Rampagy/bldc/README.md

# bldc

Open source brushless direct current (permanent magnet alternating current) hardware and software.
