Rampagy/bldc/hardware/README.md

# Kicad

Version 5.1.2

## Setup

Set Environment Variable `KILOCALLIB` to `path/to/bldc/hardware`.  This allows Kicad to find the custom schematic and footprint libraries:

* infineon.lib
* Interface_RS485.lib
* STM32F4-DISCOVERY-SIMON.lib
* custom.pretty
