Rampagy/bldc/hardware/Control/Documentation/3d_back.png

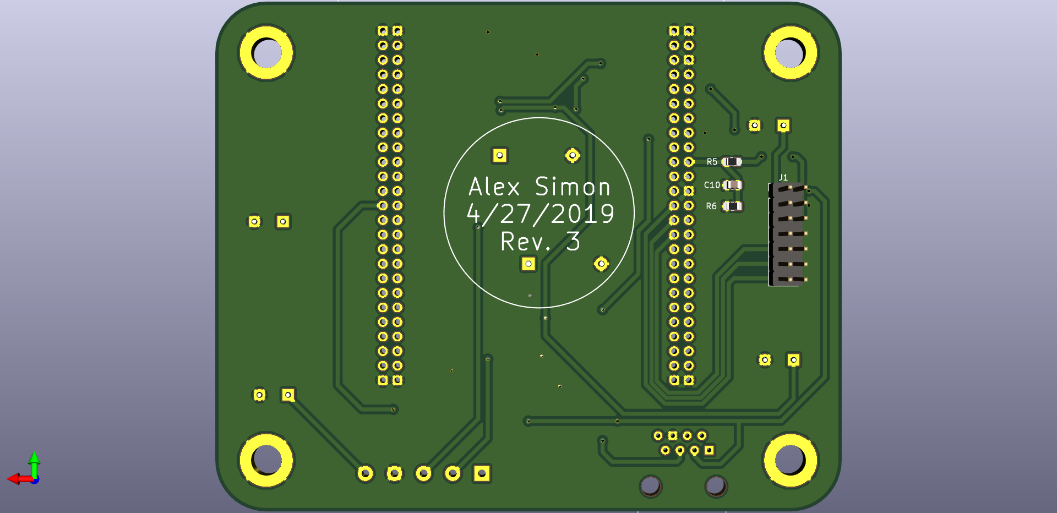
hardware/Control/Documentation/3d_back.png
