Rampagy/bldc/hardware/Control/Documentation/3d_front.png

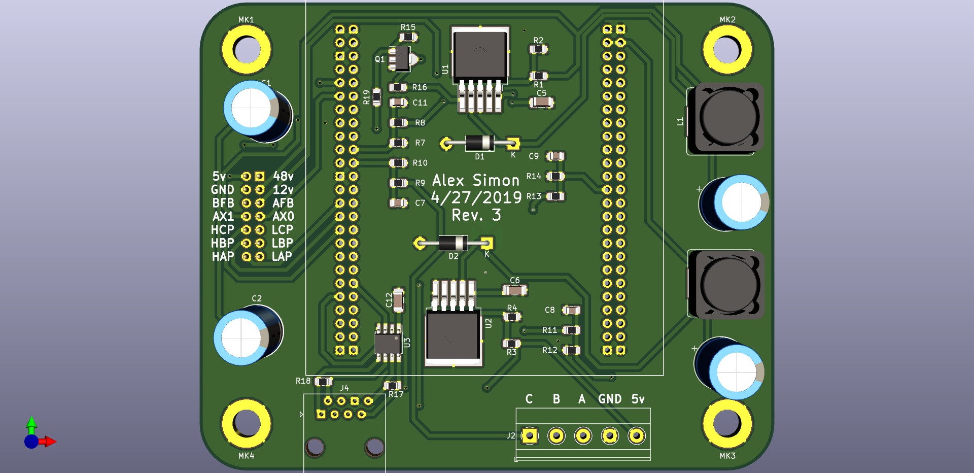
hardware/Control/Documentation/3d_front.png
