Rampagy/bldc/hardware/Operator/Documentation/3d_back.png

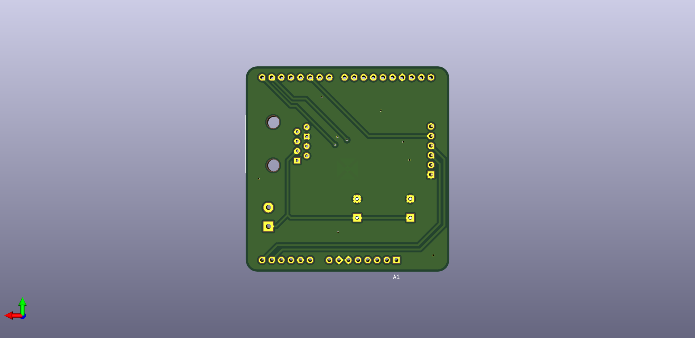
hardware/Operator/Documentation/3d_back.png
