Rampagy/bldc/hardware/Parts List 2.0.xlsx

 |  |  |  |  |  | control board | power board | both
 |  |  | total | 373.89
 |  | name | quantity | Price | digikey PN | link |  | ordered v1 | ordered v2 | ordered v3
 |  | Half Bridge Driver | 10 | 3.24 | 296-46403-1-ND | https://www.digikey.com/product-detail/en/texas-instruments/UCC27211DR/296-46403-1-ND/7033577 |  | n
 | dropin replacements | n-channel mosfet | 15 | 6.78 | IPB017N10N5ATMA1CT-ND | https://www.digikey.com/product-detail/en/infineon-technologies/IPB044N15N5ATMA1/IPB044N15N5ATMA1CT-ND/7667604 | https://www.digikey.com/product-detail/en/infineon-technologies/IPB017N10N5ATMA1/IPB017N10N5ATMA1CT-ND/5213948 | n
 |  | current sense | 4 | 4.80 | AD8210YRZ-ND | https://www.digikey.com/product-detail/en/analog-devices-inc/AD8210YRZ/AD8210YRZ-ND/1120048 |  | n
 |  | tvs diode, gate | 10 | 0.46 | SMBJ14A-FDICT-ND | https://www.digikey.com/product-detail/en/diodes-incorporated/SMBJ14A-13-F/SMBJ14A-FDICT-ND/816055 |  | n
 |  | Shottky diode | 10 | 0.45 | DFLS1100DICT-ND | https://www.digikey.com/product-detail/en/diodes-incorporated/DFLS1100-7/DFLS1100DICT-ND/765634 |  | n
buck converters | common | buck converters | 3 | 3.25 | 296-21841-1-ND | https://www.digikey.com/product-detail/en/texas-instruments/TL2575HV-ADJIKTTR/296-21841-1-ND/1629213 |  | y | y | y
 |  | schottky diode | 3 | 0.41 | 1N5819FSCT-ND | https://www.digikey.com/product-detail/en/on-semiconductor/1N5819/1N5819FSCT-ND/965482 |  | y | y | y
 |  | 2k ohm resistor | 10 | 0.10 | A126358CT-ND | https://www.digikey.com/product-detail/en/te-connectivity-passive-product/CRG0805F2K0/A126358CT-ND/7603413 |  | y | y | n
 |  | 100uF input filter cap | 10 | 0.63 | 493-12814-1-ND | https://www.digikey.com/product-detail/en/nichicon/UVR2A101MPD1TD/493-12814-1-ND/4328420 |  | y | y | n
 | 48v to 12v | 680uH inductor | 1 | 1.35 | SRR1210-681MCT-ND | https://www.digikey.com/product-detail/en/bourns-inc/SRR1210-681M/SRR1210-681MCT-ND/3461968 |  | y | y | y
 |  | 330uF cap | 2 | 0.42 | 493-7053-1-ND | https://www.digikey.com/product-detail/en/nichicon/UVZ1E331MPD1TD/493-7053-1-ND/3738374 |  | y | y | y
 |  | 18k ohm resistor | 10 | 0.36 | P18KDACT-ND | https://www.digikey.com/product-detail/en/panasonic-electronic-components/ERA-6AEB183V/P18KDACT-ND/1465977 |  | y | y | y
 | 48v to 5v | 330uH inductor | 1 | 1.35 | SRR1210-331MCT-ND | https://www.digikey.com/product-detail/en/bourns-inc/SRR1210-331M/SRR1210-331MCT-ND/3461965 |  | y | y | y
 |  | 6.04k ohm resistor | 2 | 0.10 | P6.04KCCT-ND | https://www.digikey.com/product-detail/en/panasonic-electronic-components/ERJ-6ENF6041V/P6.04KCCT-ND/119185 |  | y | y | y
 |  | 1.2mF cap, 16v | 5 | 0.69 | 493-15294-ND | https://www.digikey.com/product-detail/en/nichicon/UHV1C122MPD/493-15294-ND/2598237 |  | y | y | n
 |  | shunt resistor, 0.001, 2w | 6 | 0.68 | CSNL2512FT1L00CT-ND | https://www.digikey.com/product-detail/en/stackpole-electronics-inc/CSNL2512FT1L00/CSNL2512FT1L00CT-ND/1646259 |  | n
 |  | 10.0uF cap, 35v | 10 | 0.65 | 445-14418-1-ND | https://www.digikey.com/product-detail/en/tdk-corporation/C2012X5R1V106K125AC/445-14418-1-ND/3956084 |  | n
 |  | 0.68uF cap, 100v | 10 | 1.32 | 399-15953-1-ND | https://www.digikey.com/product-detail/en/kemet/C1210C684K1RACAUTO/399-15953-1-ND/7516453 |  | n
 |  | 10 ohm, 2w resistor | 10 | 0.39 | CRM2512-JW-100ELFCT-ND | https://www.digikey.com/product-detail/en/bourns-inc/CRM2512-JW-100ELF/CRM2512-JW-100ELFCT-ND/3438030 |  | n
 |  | 20kohm, 2/5w resistor | 10 | 0.72 | TNP20.0KACCT-ND | https://www.digikey.com/product-detail/en/vishay-dale/TNPW120620K0BEEA/TNP20.0KACCT-ND/1857150 |  | n
 |  | 1x1 screw terminal, 85 amps | 3 | 7.37 | 281-1598-ND | https://www.digikey.com/product-detail/en/weidmuller/1783660000/281-1598-ND/459455 |  | n
 |  | 1x1 screw terminal, 60 amps | 5 | 5.06 | 277-14522-ND | https://www.digikey.com/product-detail/en/phoenix-contact/1993763/277-14522-ND/4453000 |  | n
 |  | 2x25 female 0.1" header | 4 | 5.1 | SAM10038-ND | https://www.digikey.com/product-detail/en/samtec-inc/SSW-125-01-F-D/SAM10038-ND/6678775 |  | y | y | n
 |  | 1x5 screw terminal | 2 | 1.11 | ED2612-ND | https://www.digikey.com/product-detail/en/on-shore-technology-inc/OSTTC052162/ED2612-ND/614561 |  | y | y | y
 |  | 1x6 0.1" male header | 0 | 0.26 | 952-2372-ND | https://www.digikey.com/product-detail/en/harwin-inc/M20-9710646/952-2372-ND/3724334 |  | y
 |  | rj45 connector | 5 | 0.6 | 609-1046-ND | https://www.digikey.com/product-detail/en/amphenol-icc-fci/54602-908LF/609-1046-ND/1001360 |  | y | y | n
 |  | 2.2uF cap, 100v | 10 | 0.63 | 490-14438-1-ND | https://www.digikey.com/product-detail/en/murata-electronics/GCM31CC72A225KE02L/490-14438-1-ND/6606899 |  | y | y | n
 |  | 14pin shrouded connector | 2 | 0.33 | ED10522-ND | https://www.digikey.com/product-detail/en/on-shore-technology-inc/302-S141/ED10522-ND/2794233 |  | y | y | n
 |  | ribbon cable | 1 | 3.22 | M3DDA-1406R-ND | https://www.digikey.com/product-detail/en/3m/M3DDA-1406R/M3DDA-1406R-ND/230201 |  | y
 |  | 680 ohm resistor | 20 | 0.1 | A129747CT-ND | https://www.digikey.com/product-detail/en/te-connectivity-passive-product/CRGCQ0805F680R/A129747CT-ND/8577579 |  | y | y | n
 |  | 2.2nF cap, 25v | 10 | 0.36 | 478-3753-1-ND | https://www.digikey.com/product-detail/en/avx-corporation/08053A222JAT2A/478-3753-1-ND/1116451 |  | y | y | y
 |  | 30kohm, 1/8w resistor | 5 | 0.36 | P30KDACT-ND | https://www.digikey.com/product-detail/en/panasonic-electronic-components/ERA-6AEB303V/P30KDACT-ND/1465982 |  | y | y | y
 |  | rs232 to usb converter cable | 1 | 19.81 |  | https://www.amazon.com/Adafruit-Serial-TTL-232-Cable-ADA70/dp/B00SK8LK1W |  | y
 |  | NPN BJT, 80V, 1Amp | 2 | 0.47 | BCX5616CT-ND | https://www.digikey.com/product-detail/en/diodes-incorporated/BCX5616TA/BCX5616CT-ND/190920 |  | n | y | n
 |  | RS485 driver/receiver | 10 | 1.537 | 296-35376-1-ND | https://www.digikey.com/product-detail/en/texas-instruments/DS89C21TMX-NOPB/296-35376-1-ND/3739080 |  | n | y | n
 |  | 120 ohm resistor | 10 | 0.052 | A126336CT-ND | https://www.digikey.com/product-detail/en/te-connectivity-passive-product/CRG0805F120R/A126336CT-ND/7603391 |  | n | y | n
 |  | 1x2 Screw Terminal, 18 amps | 2 | 0.43 | 277-1667-ND | https://www.digikey.com/product-detail/en/phoenix-contact/1935161/277-1667-ND/568614 |  | n | y | n
 |  | 680uF cap, 100V | 5 | 2.05 | 493-1987-ND | https://www.digikey.com/product-detail/en/nichicon/UPW2A681MHD/493-1987-ND/589728
 |  | 4.7uF cap, 100V | 10 | 0.92 | 587-5038-1-ND | https://www.digikey.com/product-detail/en/taiyo-yuden/HMK325C7475KN-TE/587-5038-1-ND/6563881
