Rampagy/bldc/(threads)

Thread 2 (2019-06-14):

Go back to count up mode

Rampagy, 2019-06-14:
https://github.com/Rampagy/bldc/blob/b7856c2639916a426cf8b4d859cf875d4ca604d4/software/Control/pwm_output.c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

should be

    TIM_BaseStruct.TIM_CounterMode = TIM_CounterMode_Up;

Rampagy, 2019-06-14:
Going to stay with center aligned mode to reduce all of the phases switching at the same time and unnecessarily inducing EMI that isn't needed.

Closed 2019-06-14.

Thread 3 (2019-06-14):

Change to PWM mode 1

Rampagy, 2019-06-14:
https://github.com/Rampagy/bldc/blob/b7856c2639916a426cf8b4d859cf875d4ca604d4/software/Control/pwm_output.c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

should be

    TIM_OCStruct.TIM_OCMode = TIM_OCMode_PWM1;

Rampagy, 2019-06-14:
Going to stay with center aligned mode to reduce all of the phases switching at the same time and unnecessarily inducing EMI that isn't needed.

Closed 2019-06-14.

Thread 4 (2019-06-14):

Wrong Polarity

Rampagy, 2019-06-14:
https://github.com/Rampagy/bldc/blob/b7856c2639916a426cf8b4d859cf875d4ca604d4/software/Control/pwm_output.c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

should be

    TIM_OCStruct.TIM_OCPolarity = TIM_OCPolarity_High;
    TIM_OCStruct.TIM_OCNPolarity = TIM_OCNPolarity_High;

Closed 2019-06-17.

Thread 5 (2019-06-14):

Wrong period

Rampagy, 2019-06-14:
https://github.com/Rampagy/bldc/blob/b7856c2639916a426cf8b4d859cf875d4ca604d4/software/Control/pwm_output.c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

should be

    timerPeriod = (uint16_t)(((uint32_t)SystemCoreClock / PWM_FREQ_HZ) - 1);

This is to account for the fact that we are no longer doing center aligned mode.

Rampagy, 2019-06-14:
Going to stay with center aligned mode to reduce all of the phases switching at the same time and unnecessarily inducing EMI that isn't needed.

Closed 2019-06-14.

Thread 6 (2019-06-17):

Polarity Issue

Rampagy, 2019-06-17:
https://github.com/Rampagy/bldc/blob/72862fa5c6fe0d044080ef48e1f8bc80b7bbeef1/software/Control/pwm_output.c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

Let's give the below configuration a try and see if it gets us what we want.

    TIM_OCInitStructure.TIM_OCPolarity = TIM_OCPolarity_Low;
    TIM_OCInitStructure.TIM_OCNPolarity = TIM_OCNPolarity_Low;
    /* Set Idle state to Reset for all FETs, so break can be used for neutral */
    TIM_OCInitStructure.TIM_OCIdleState = TIM_OCIdleState_Set;
    TIM_OCInitStructure.TIM_OCNIdleState = TIM_OCIdleState_Reset;

Closed 2019-07-01.

Thread 7 (2019-07-08):

Incorrect Phase Angle Estimation

Rampagy, 2019-07-08:
https://github.com/Rampagy/bldc/blob/d132e3d7ee893cea09e6aa9a4d93e508efb8d261/software/Control/motor_control.c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

The above code incorrectly drives the quadrature angle 60 degrees ahead of the direct angle when PHASE_PREDICTION is enabled.  To fix this issue the below changes are recommended:

    #ifdef PHASE_PREDICTION
        uint16_t currentTimerCount = motorSpeedTimerOverrun ? TIM13_PERIOD : TIM13->CNT;
        uint16_t predictedPhaseAngle = (((uint32_t)currentTimerCount * 100 * 60) / motorSpeedCount) / 100;
    #else
        // half of the hall effect resolution, so that active torque region is centered around max torque point
        uint16_t predictedPhaseAngle = 30;
    #endif

        int16_t quadratureAxisAngle = checkAngleOverflow(directAxisAngle + 90 + predictedPhaseAngle);

Rampagy, 2019-07-09:
Fixed PHASE_PREDICTION bug with commit: 08e51591bc963561a74c99b4e07ac175a42cce6e

Closed 2019-07-09.
