Rampagy/bldc/hardware/Control/Documentation/control_v1.pdf

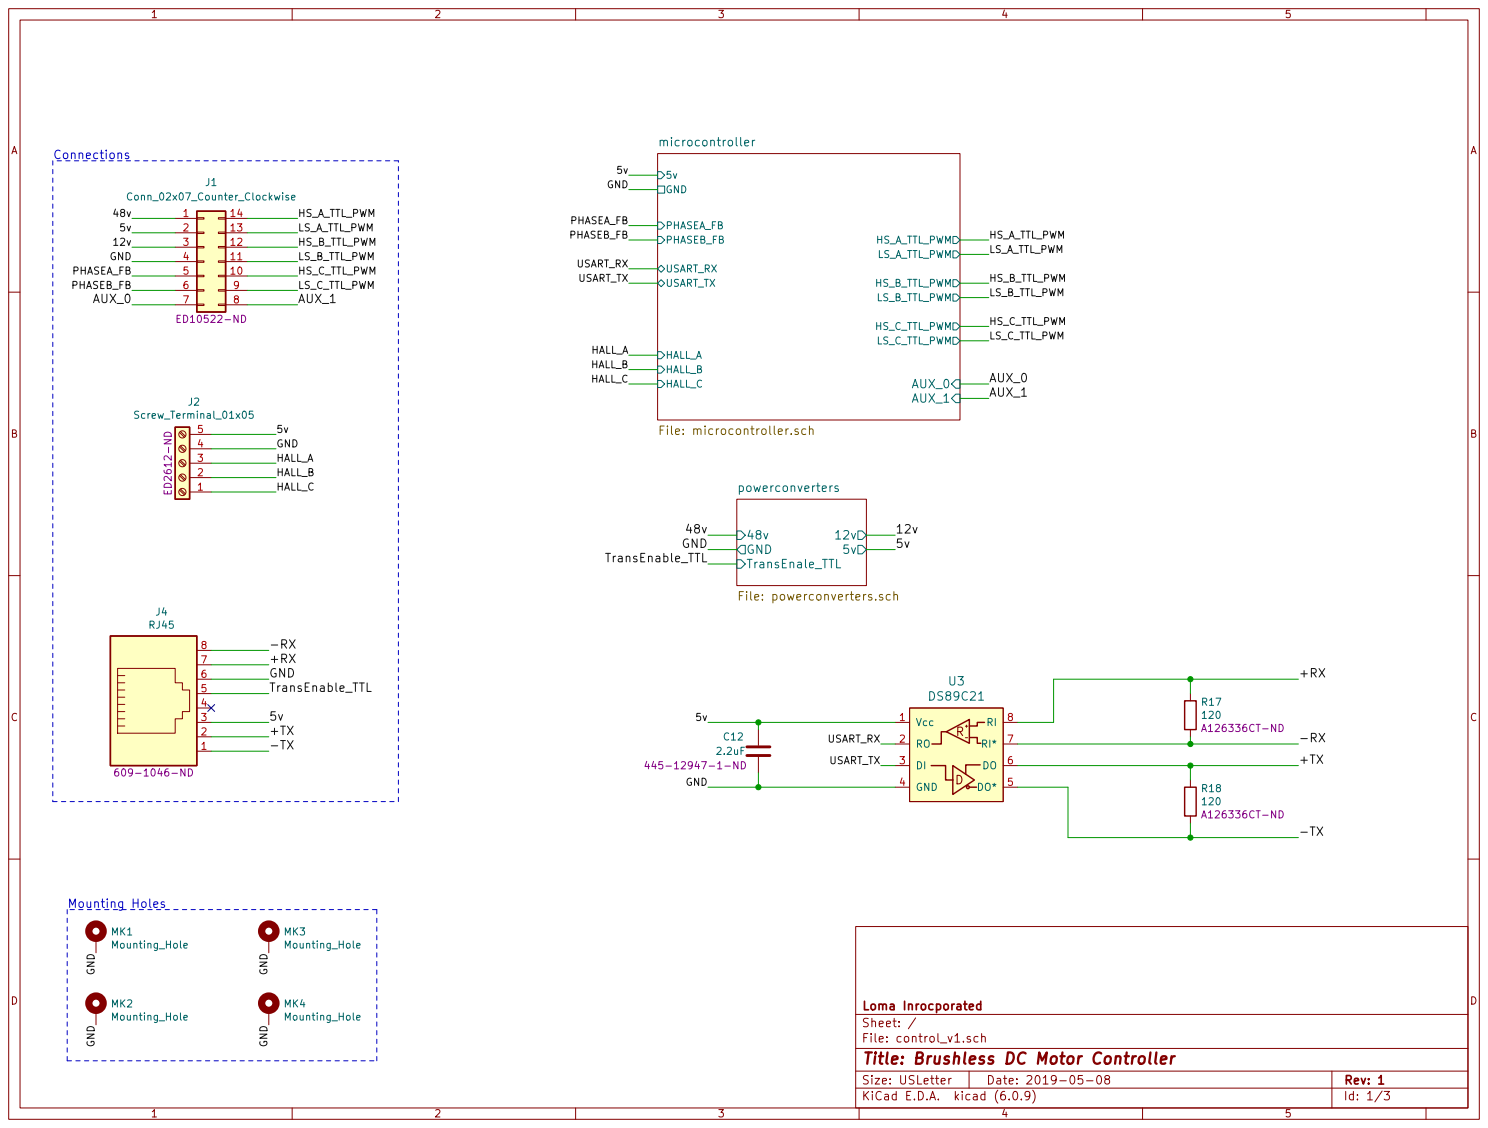
[picture p9: page 1]

File: control_v1.sch Sheet: / Loma Inrocporated

Id: 1/3 Title: Brushless DC Motor Controller

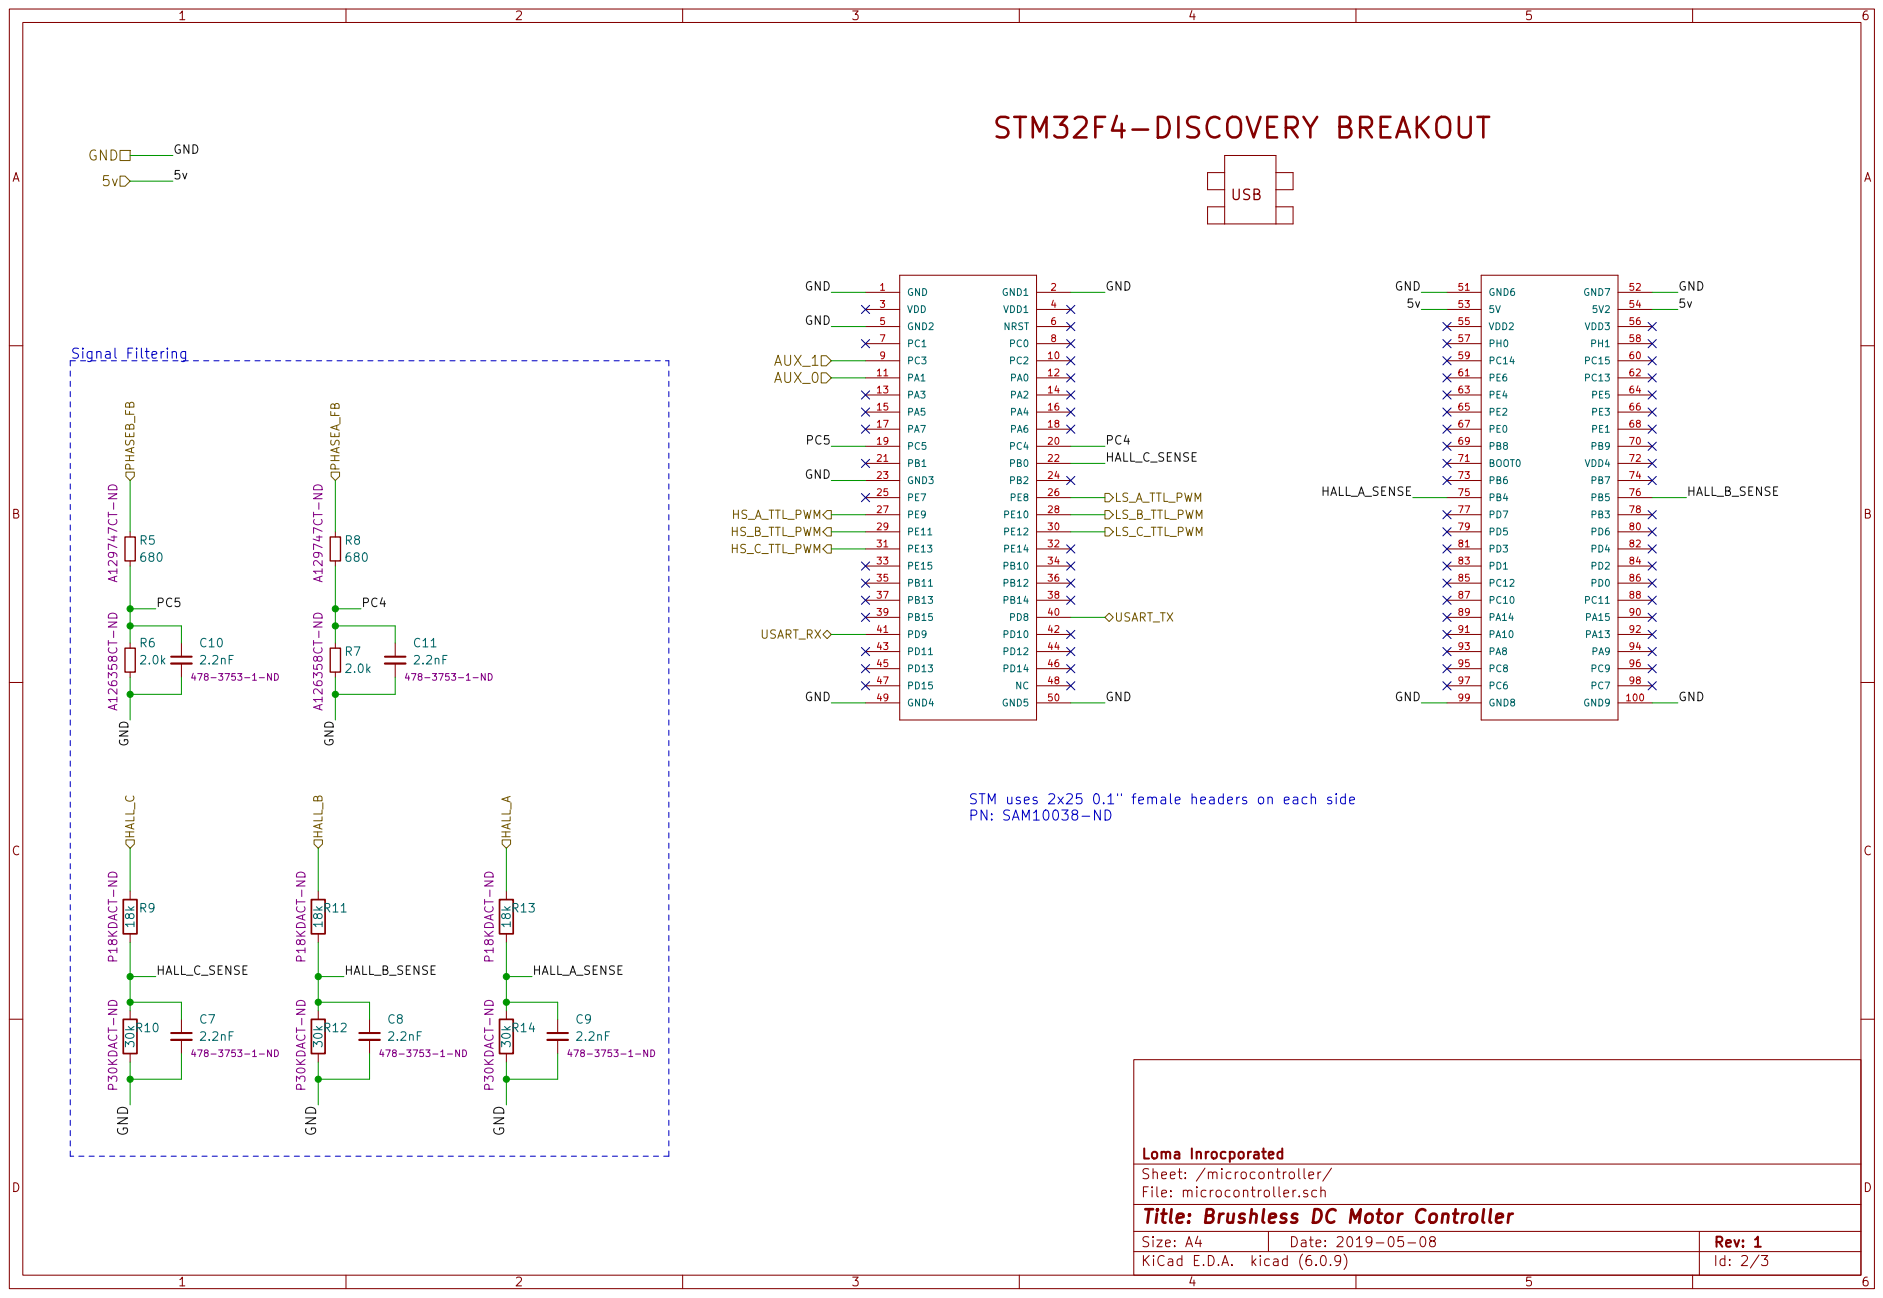
[picture p10: page 2]

Id: 2/3 Title: Brushless DC Motor Controller File: microcontroller.sch Sheet: /microcontroller/ Loma Inrocporated C10

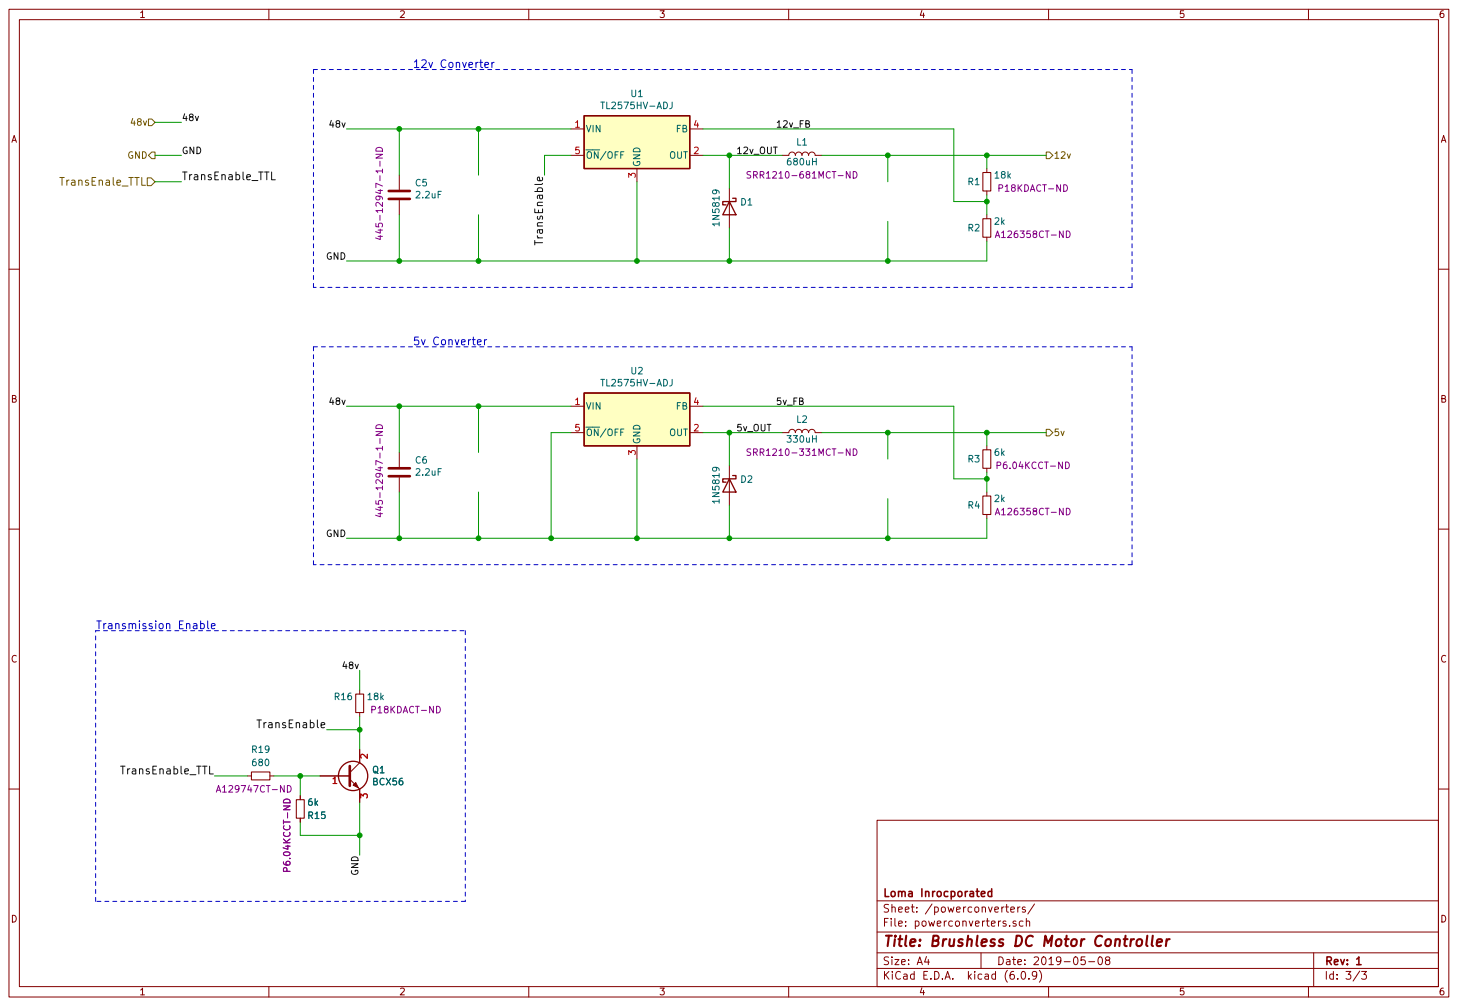
[picture p11: page 3]

3 FB 4 ~{ON}/OFF 5 U1 TL2575HV-ADJ R2 2kA126358CT-ND

3 FB 4 ~{ON}/OFF 5 U2 TL2575HV-ADJ R15
48v GND

Loma Inrocporated
Sheet: /powerconverters/
File: powerconverters.sch
Id: 3/3 Title: Brushless DC Motor Controller
