Rampagy/bldc/hardware/Power/Documentation/bldc_v1.pdf

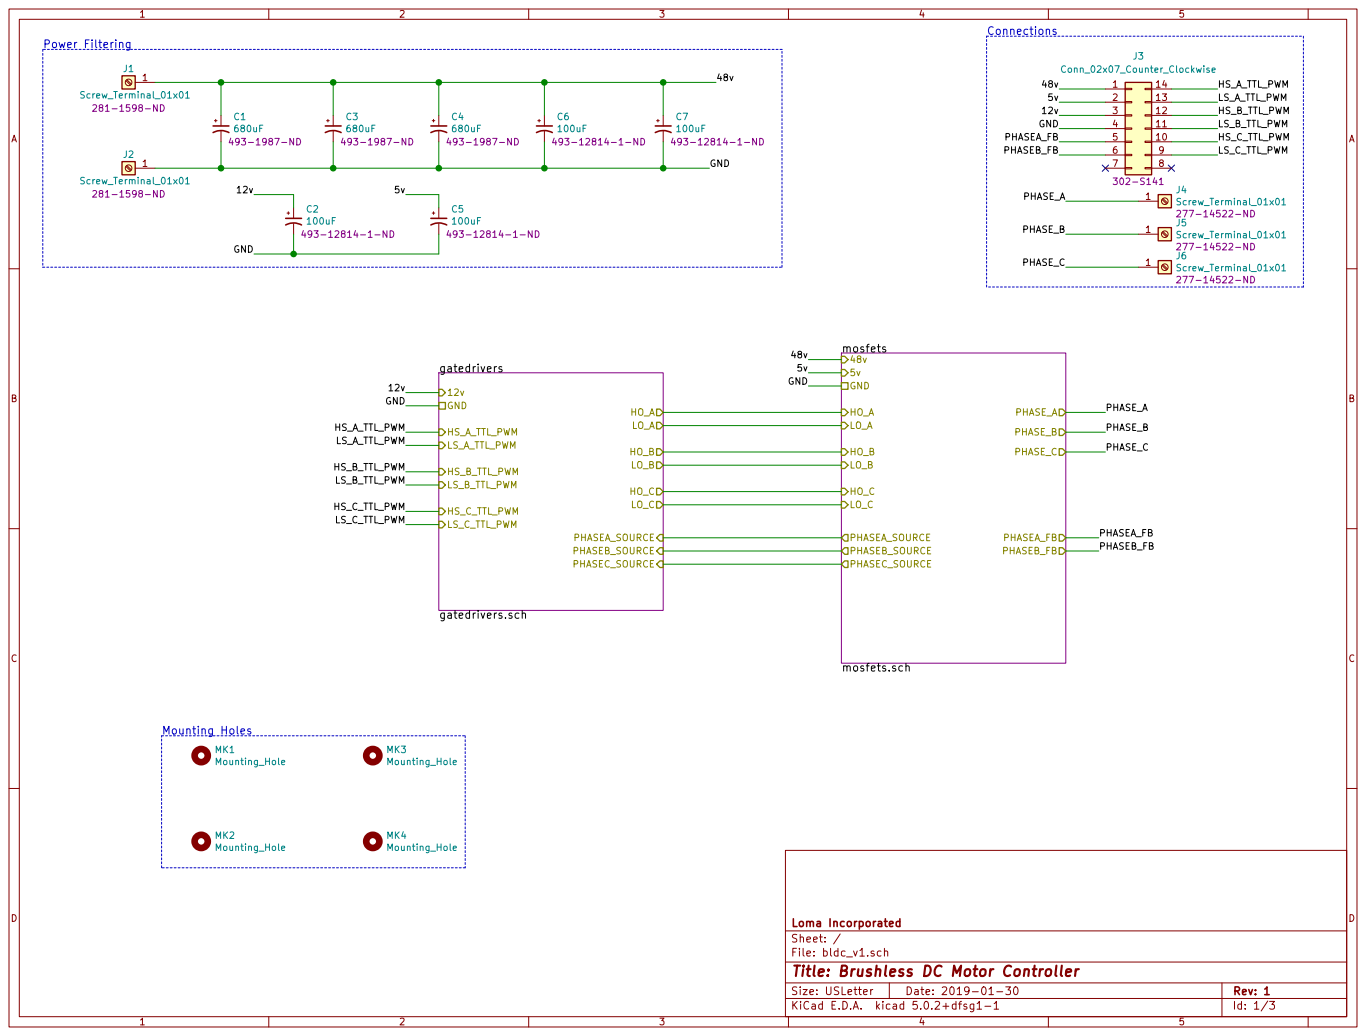
[picture p12: page 1]

File: bldc_v1.sch Sheet: / Loma Incorporated

Id: 1/3 Title: Brushless DC Motor Controller

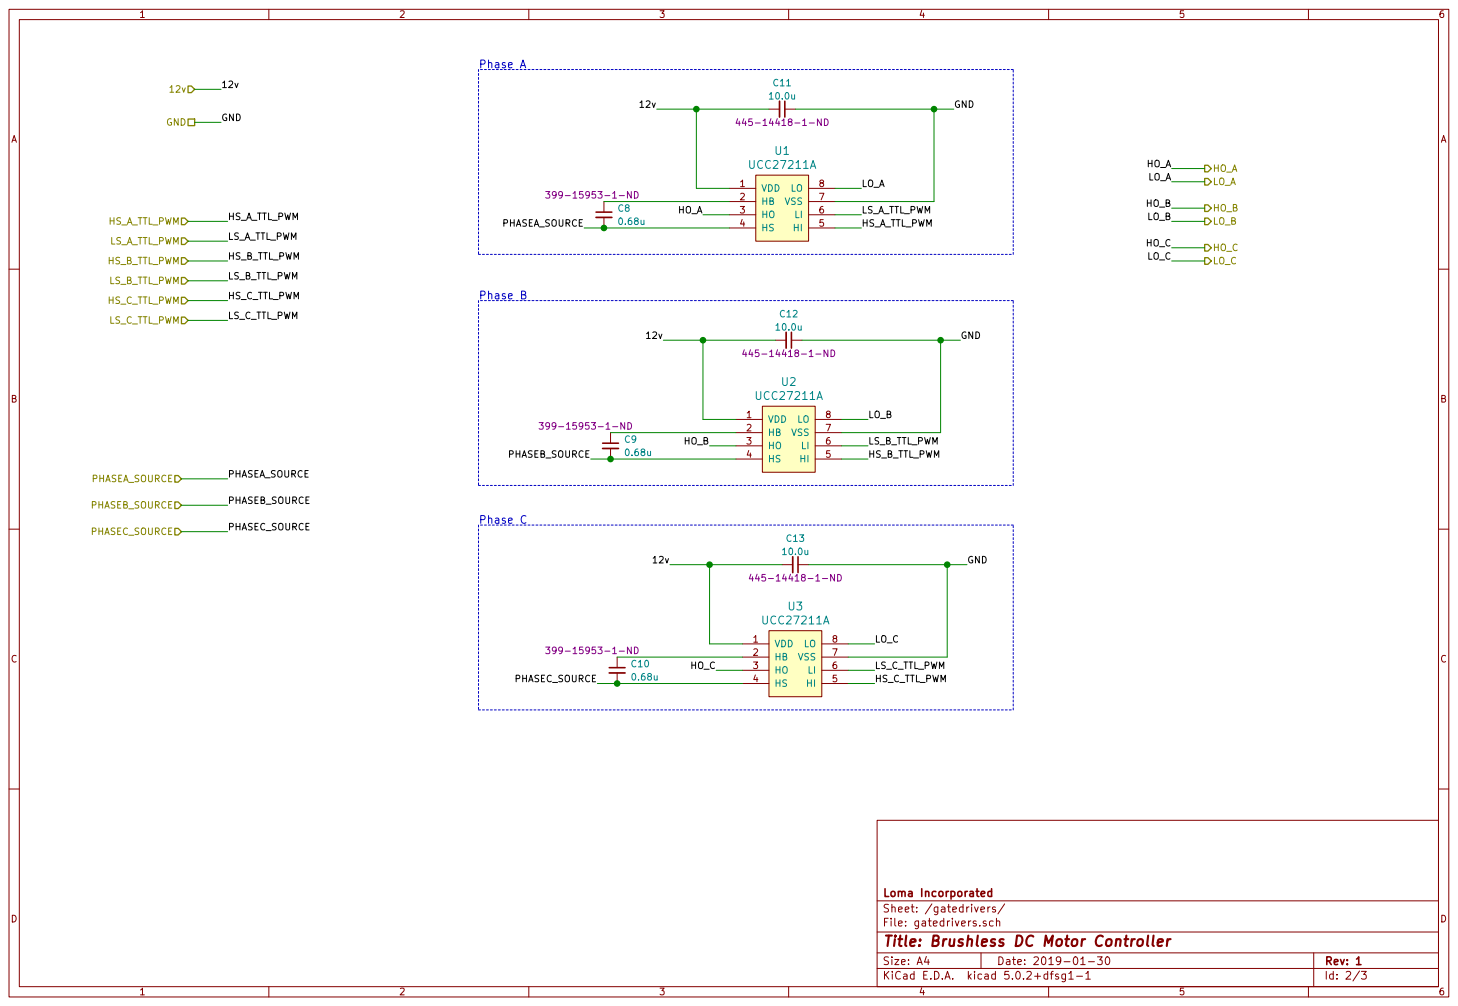
[picture p13: page 2]

Loma Incorporated
Sheet: /gatedrivers/
File: gatedrivers.sch
Id: 2/3 Title: Brushless DC Motor Controller

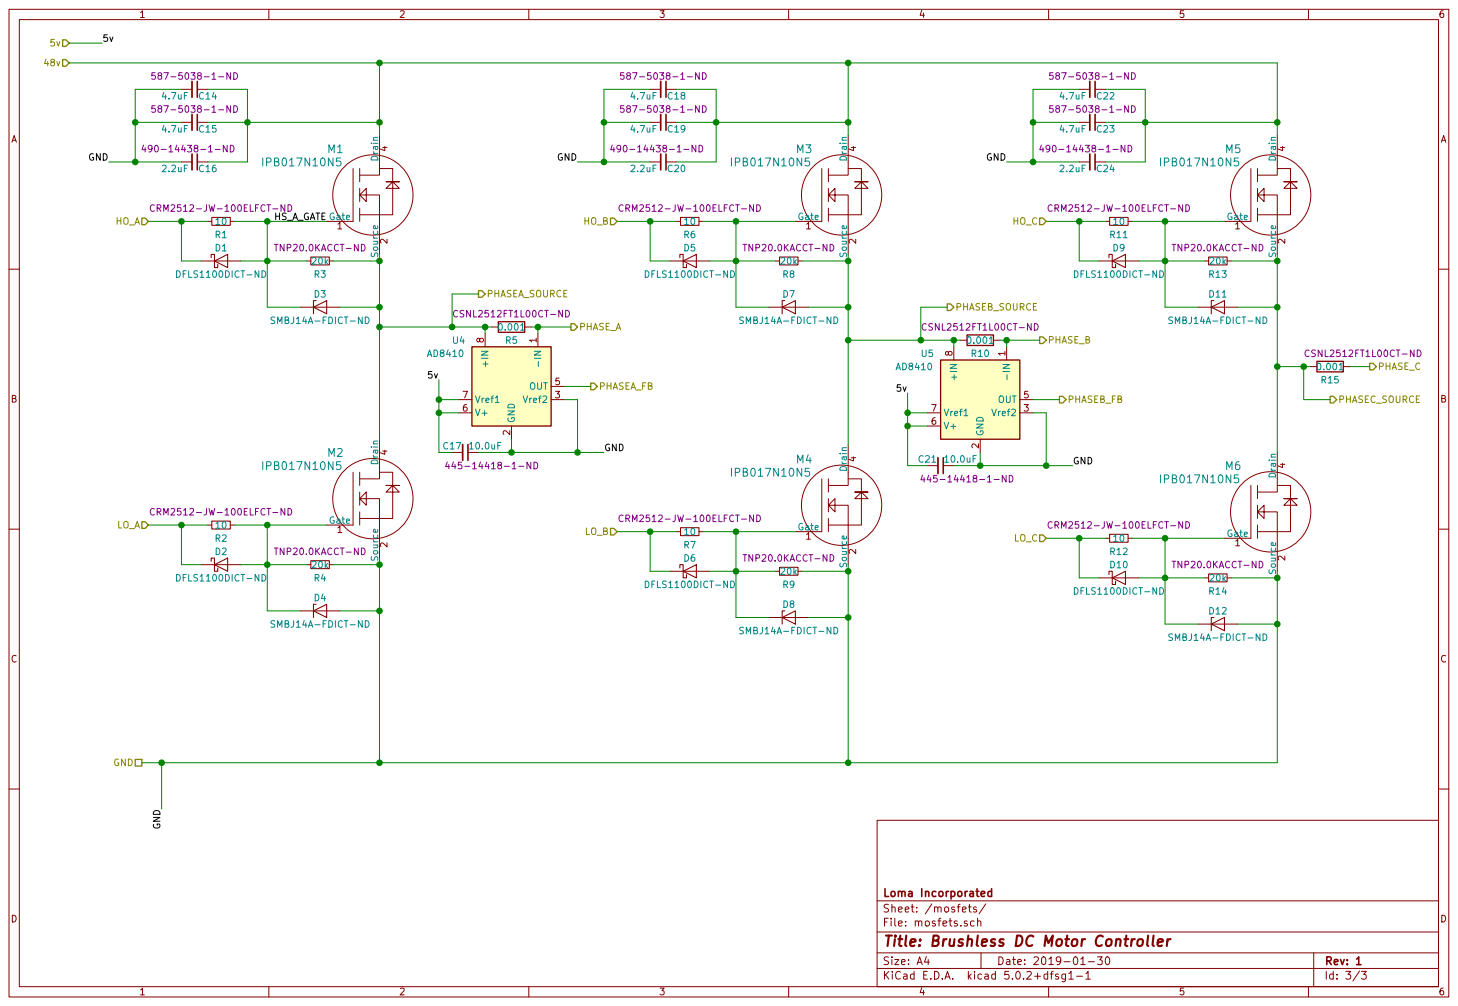
[picture p14: page 3]

D11 SMBJ14A-FDICT-ND GND Gate

Id: 3/3 Title: Brushless DC Motor Controller File: mosfets.sch Sheet: /mosfets/ Loma Incorporated
