Rampagy/bldc/hardware/Operator/Documentation/board_expanded.pdf

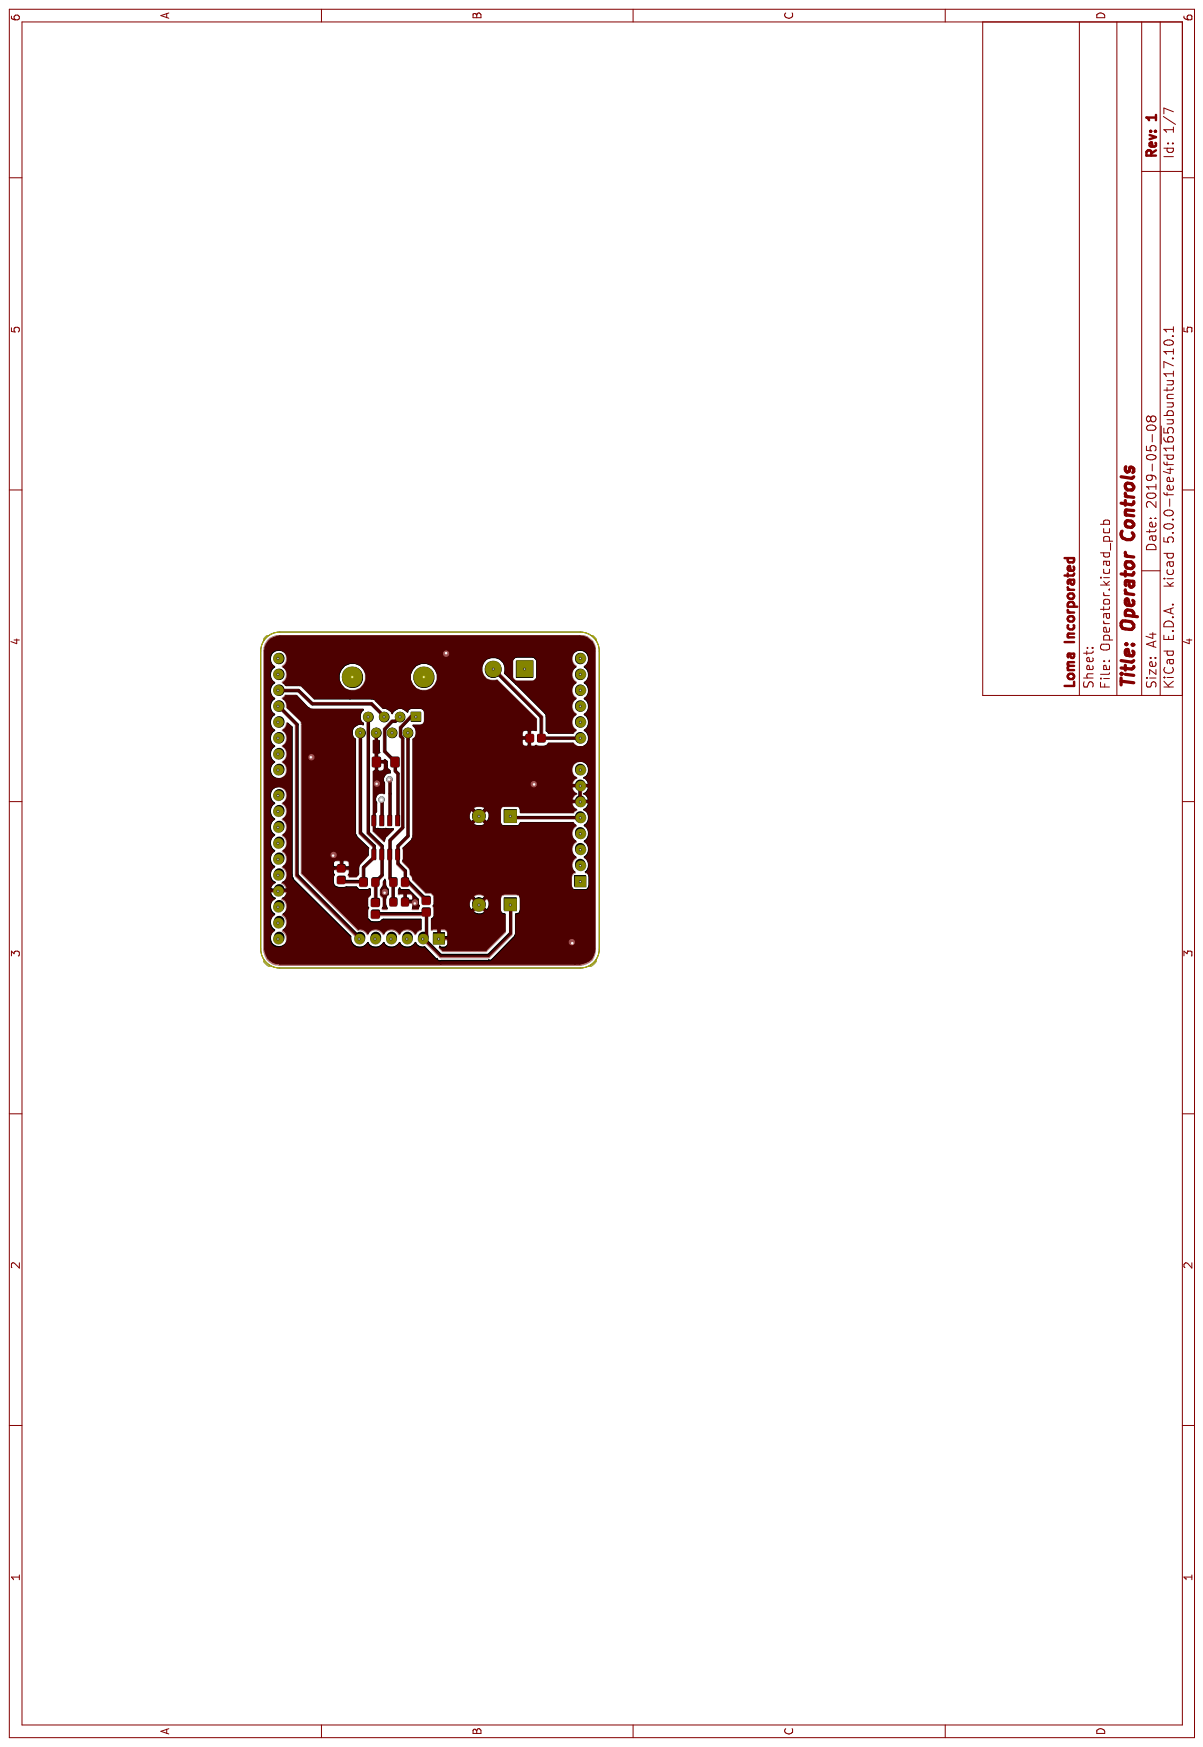
[picture p15: page 1]

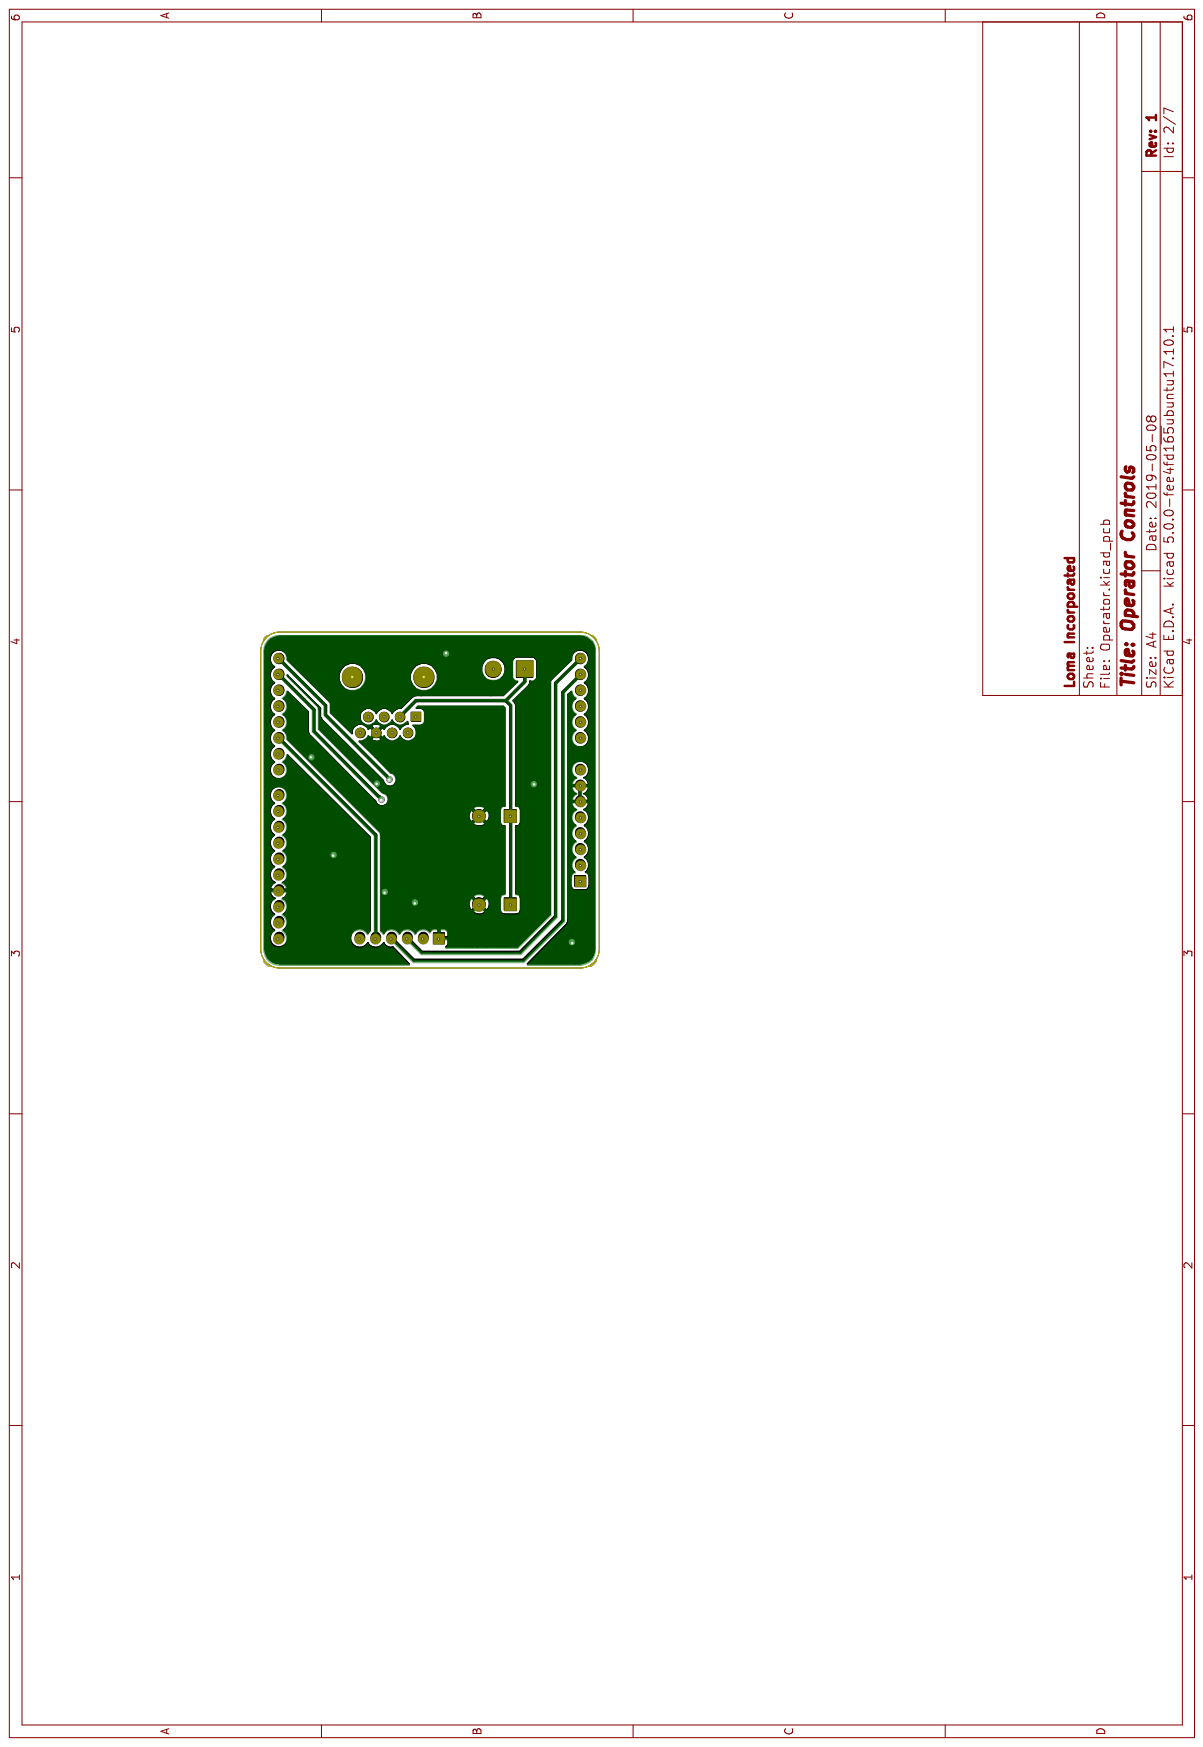
[picture p16: page 2]

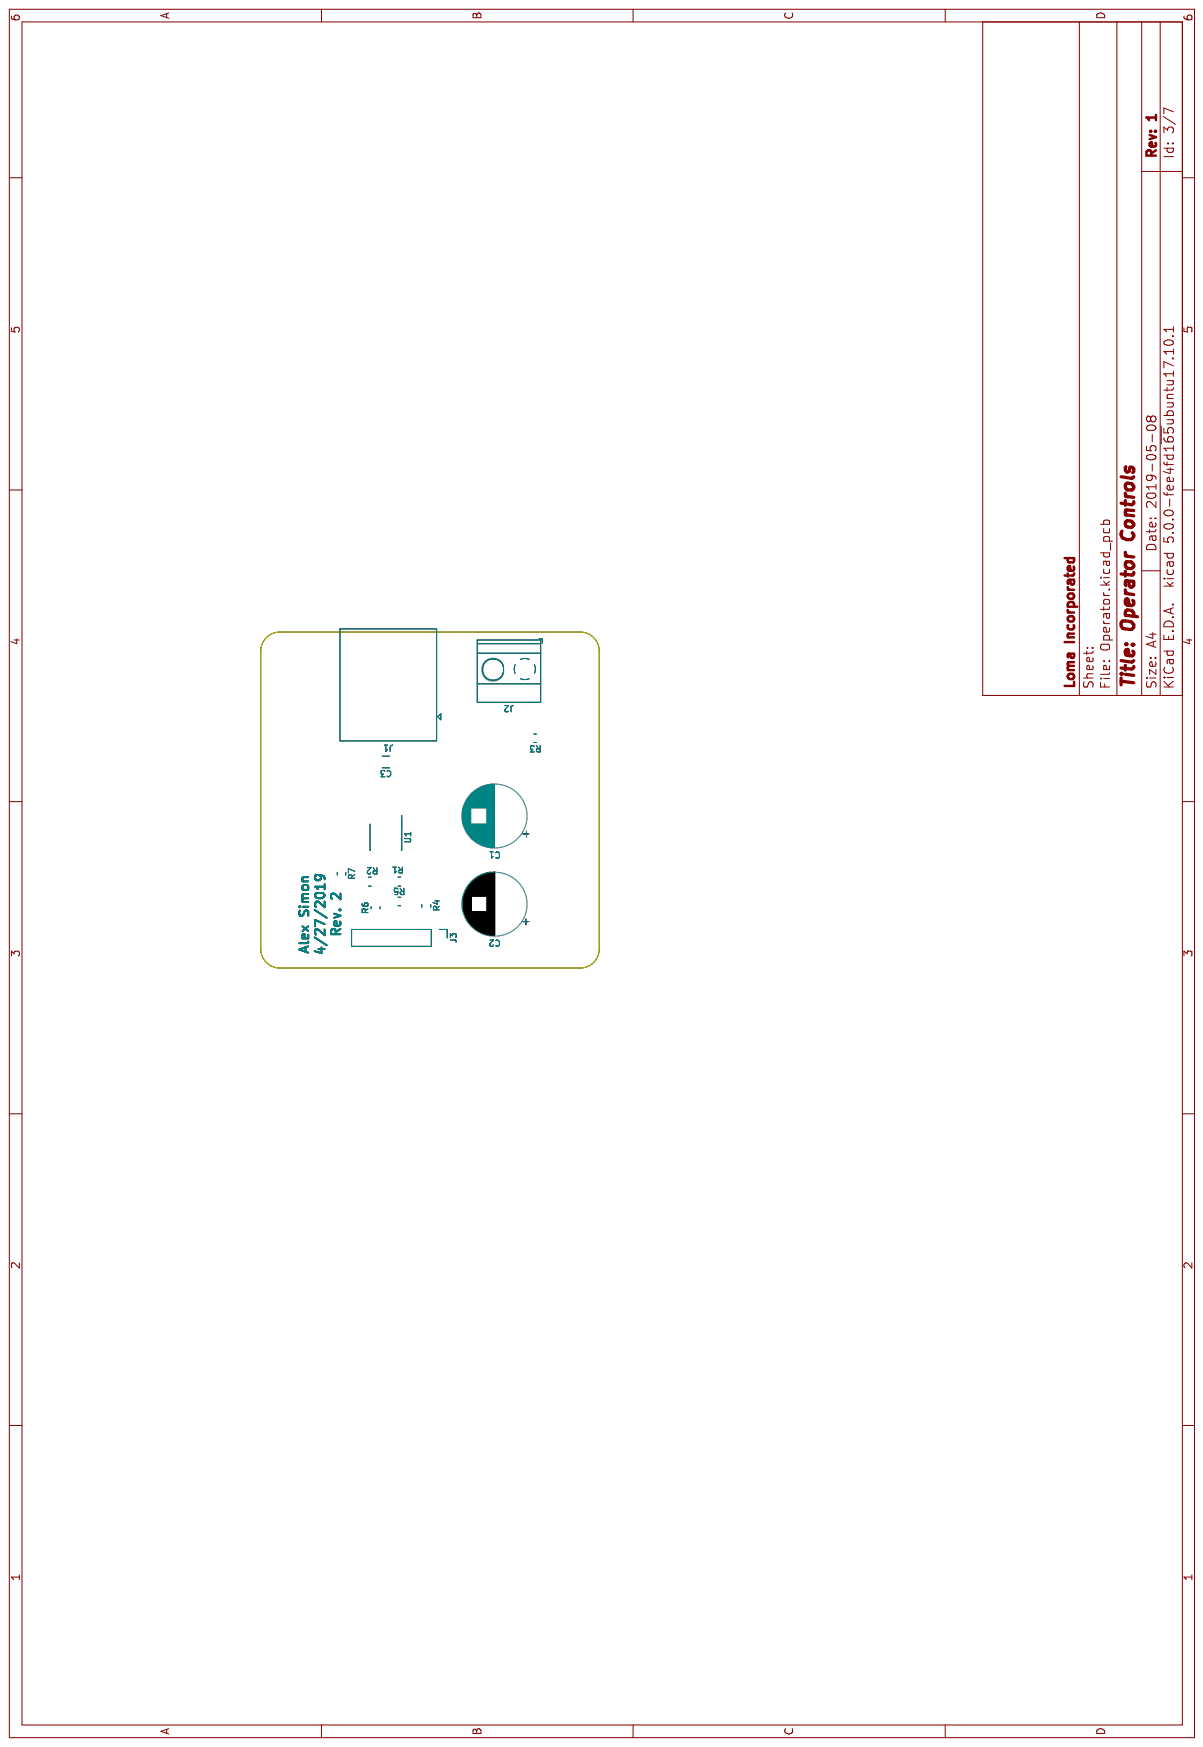
[picture p17: page 3]

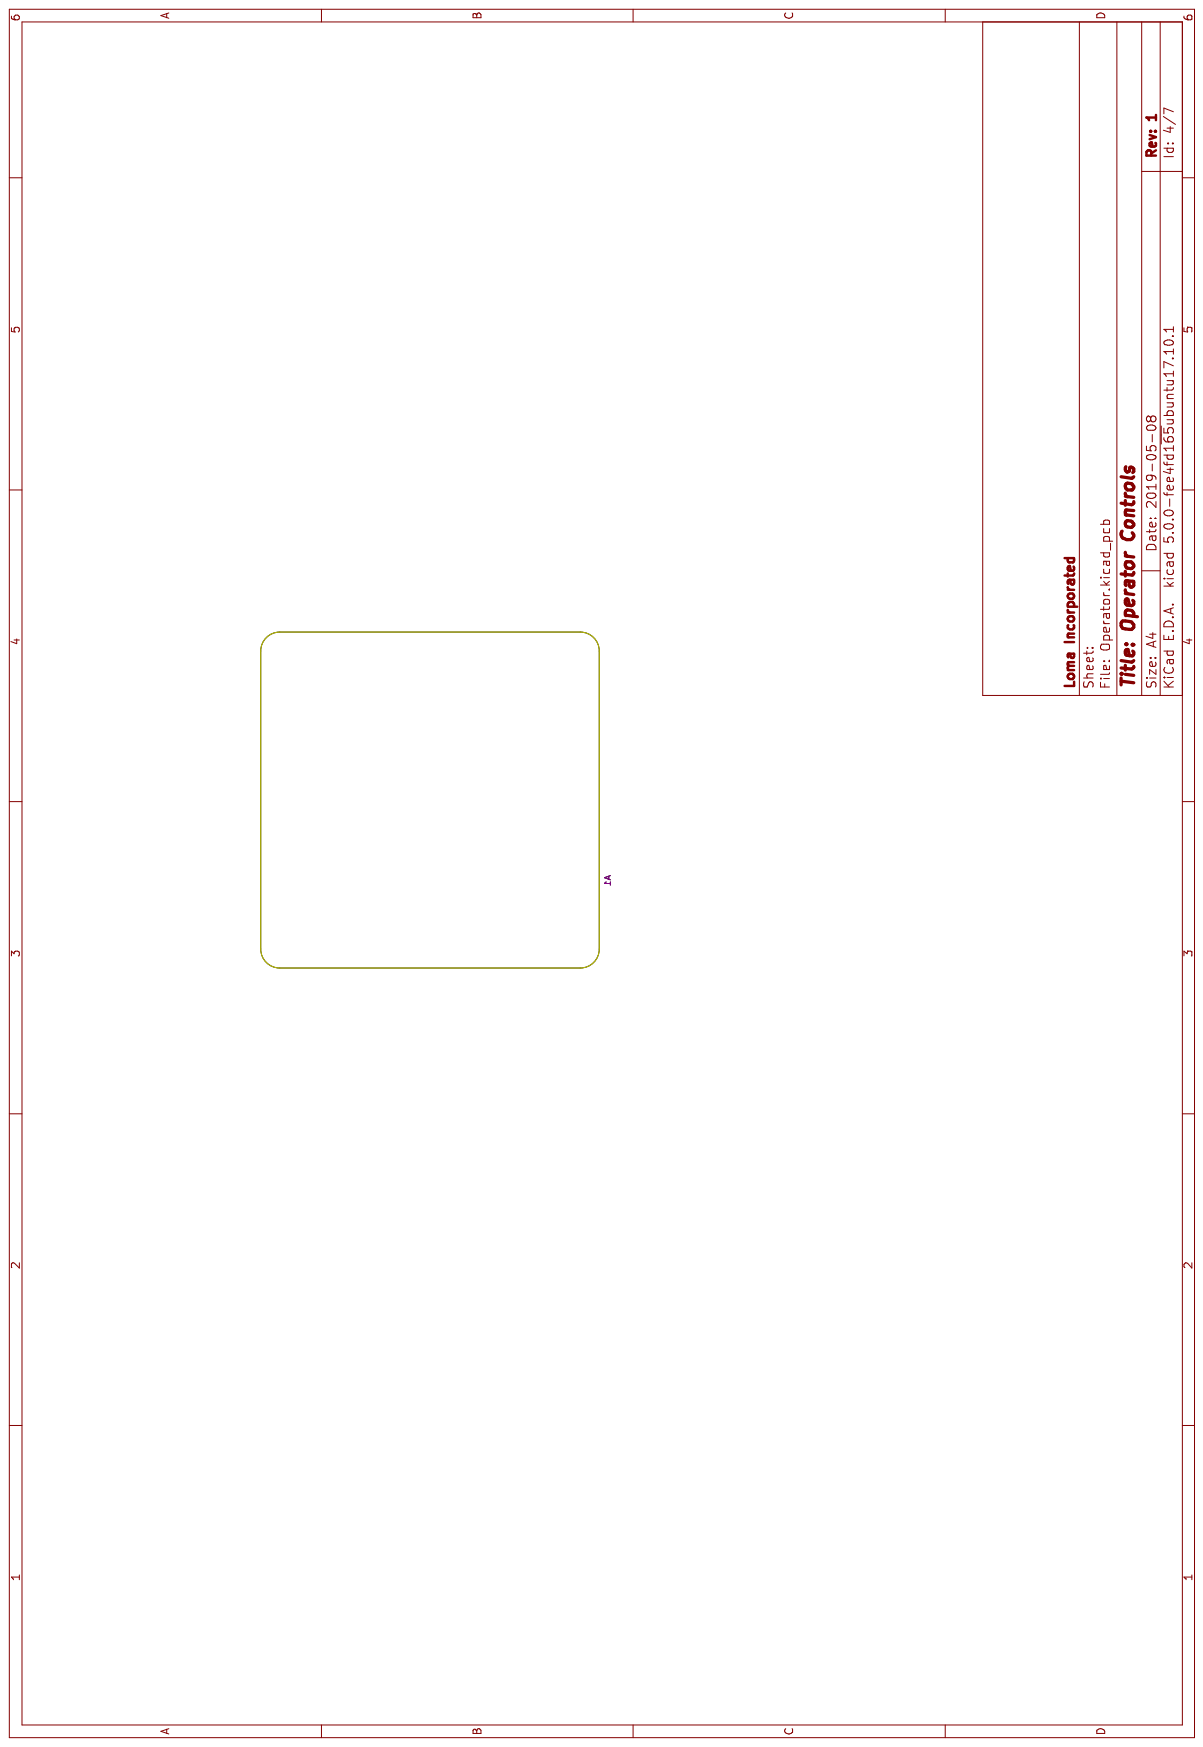
[picture p18: page 4]

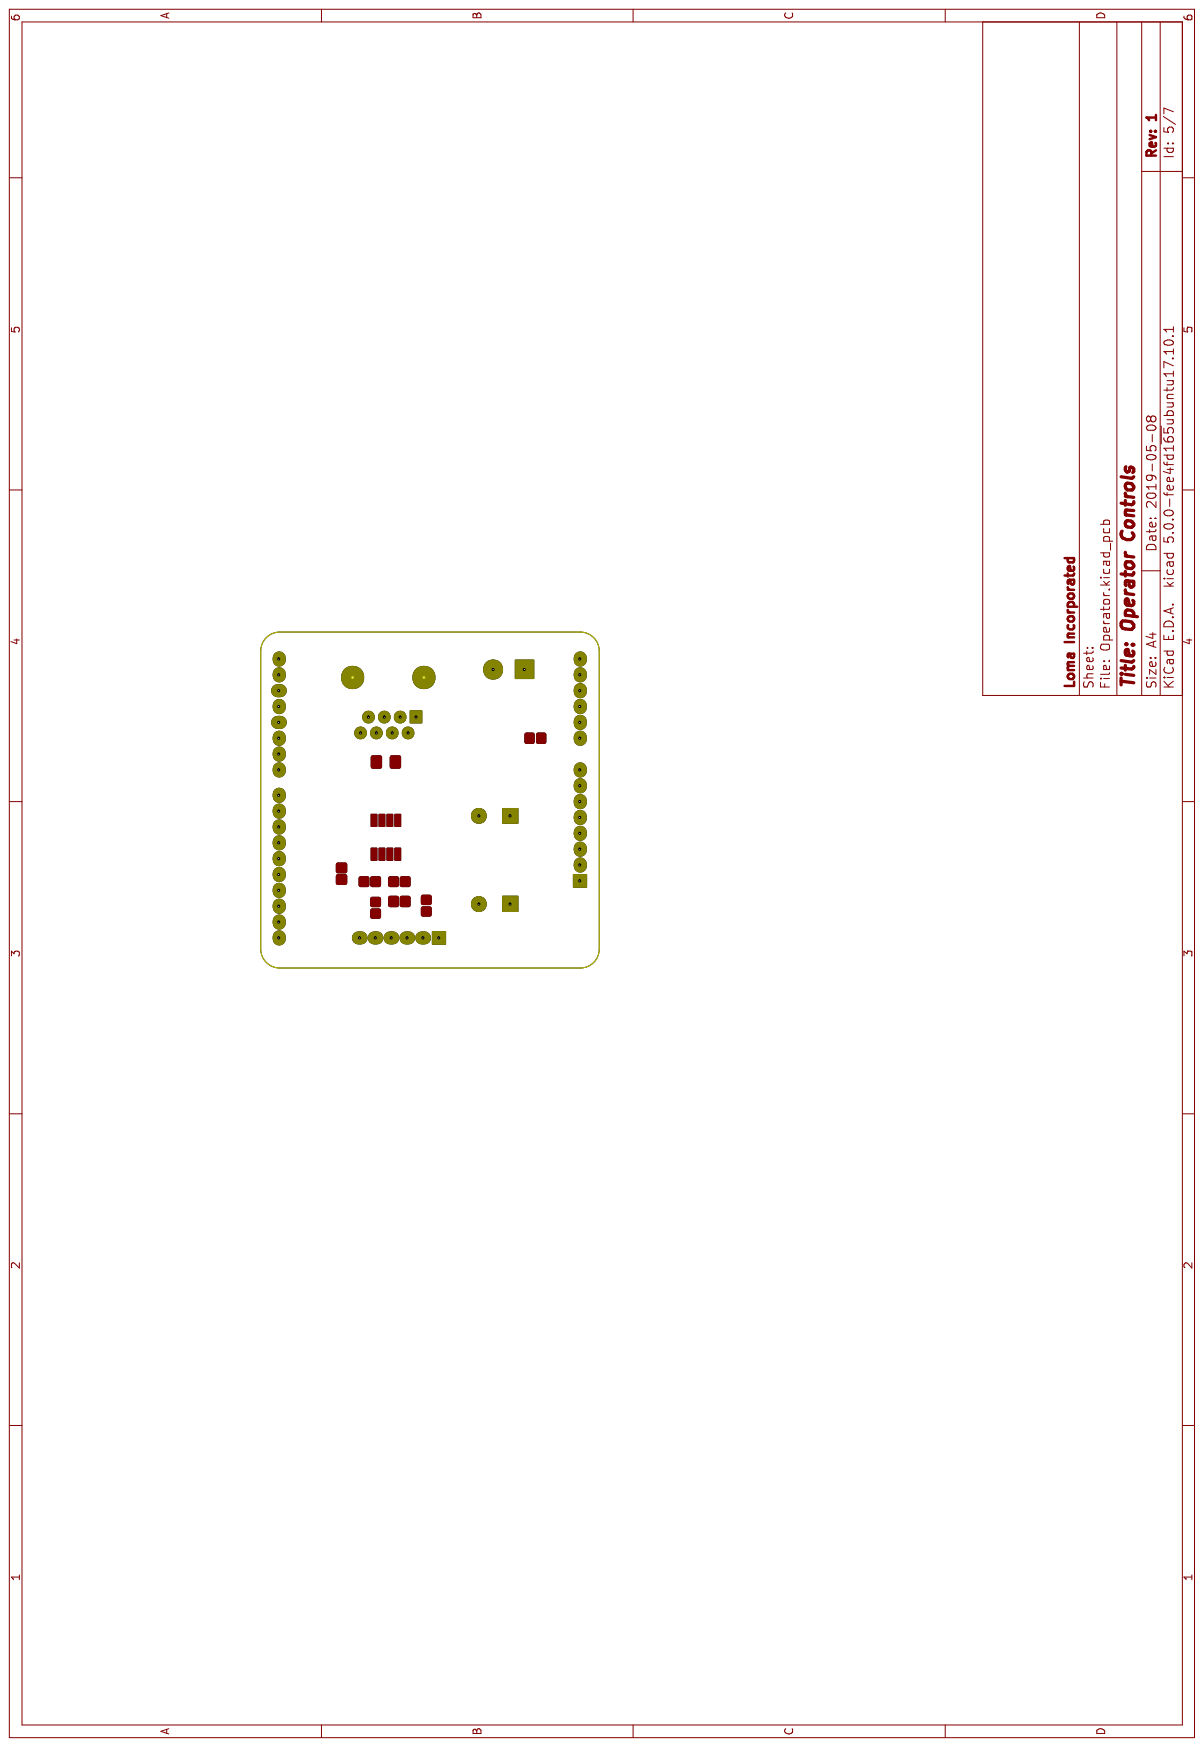
[picture p19: page 5]

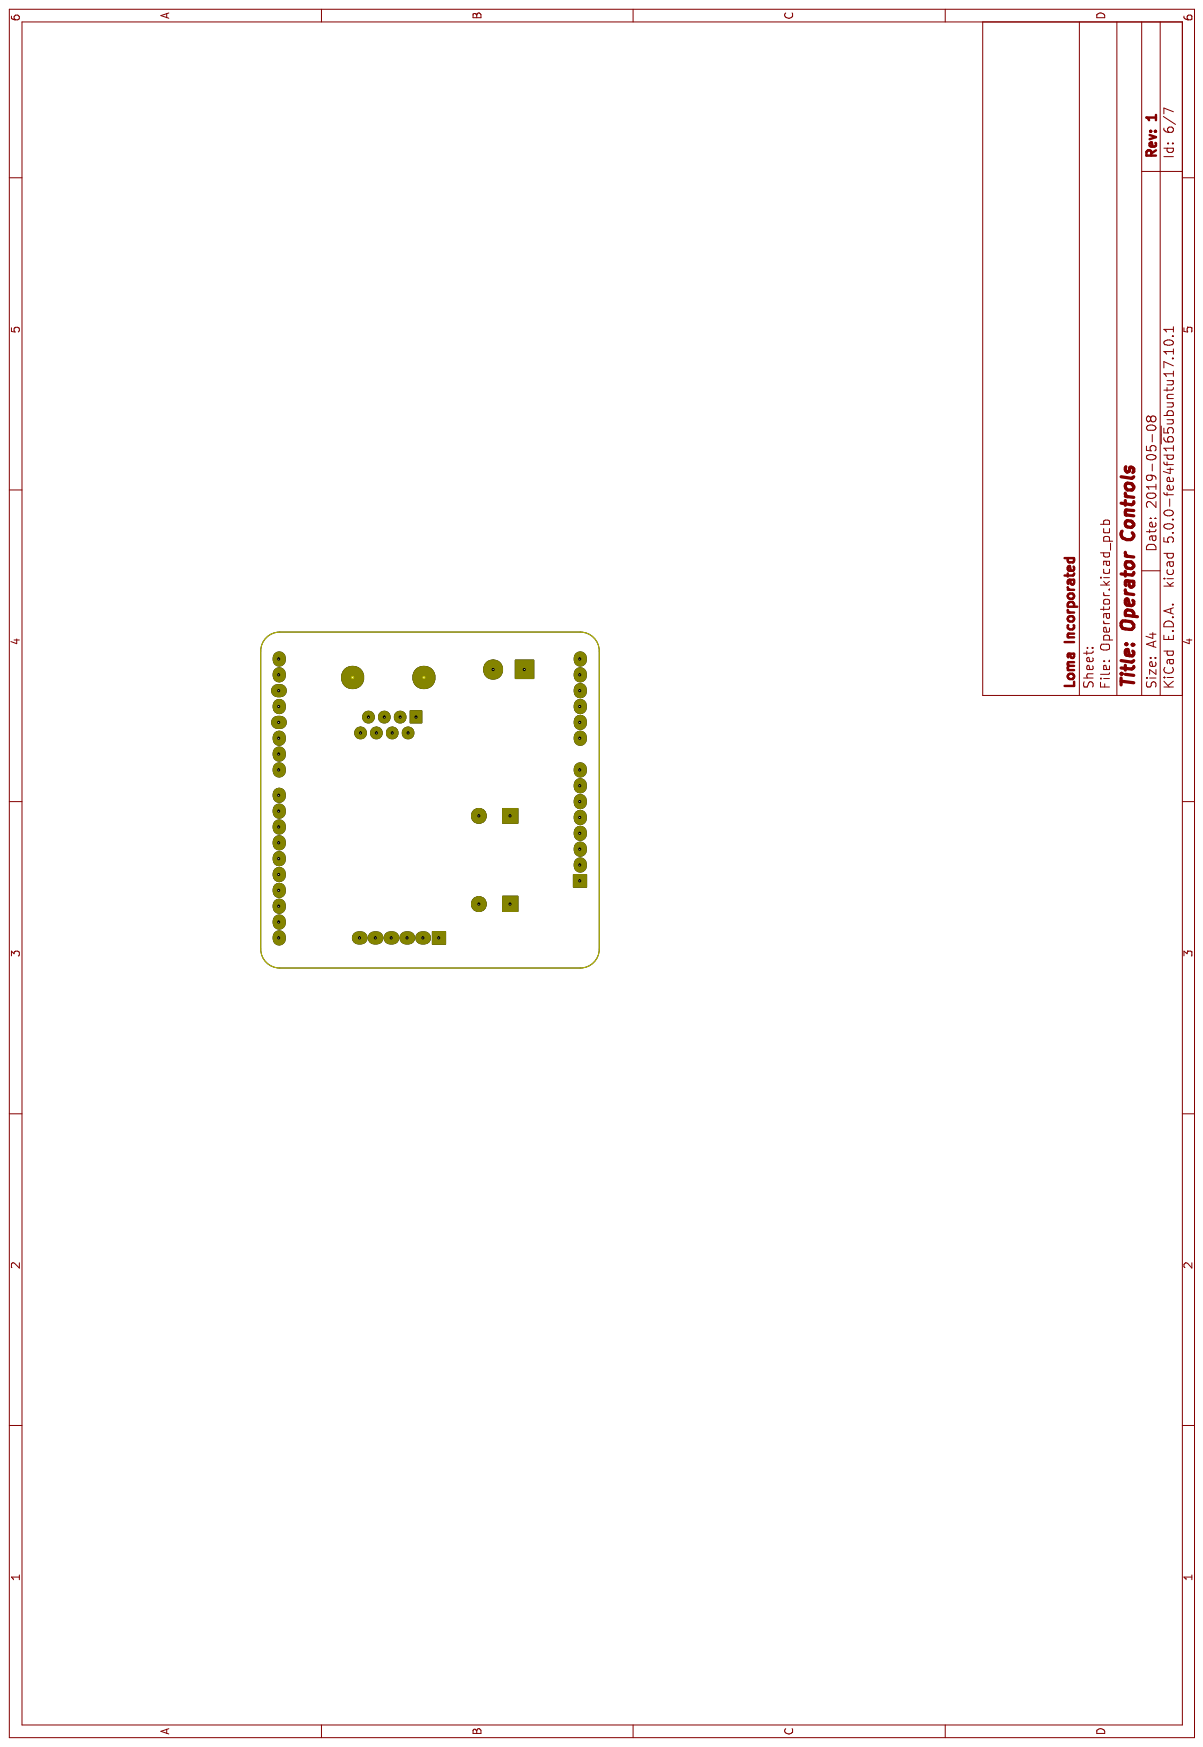
[picture p20: page 6]

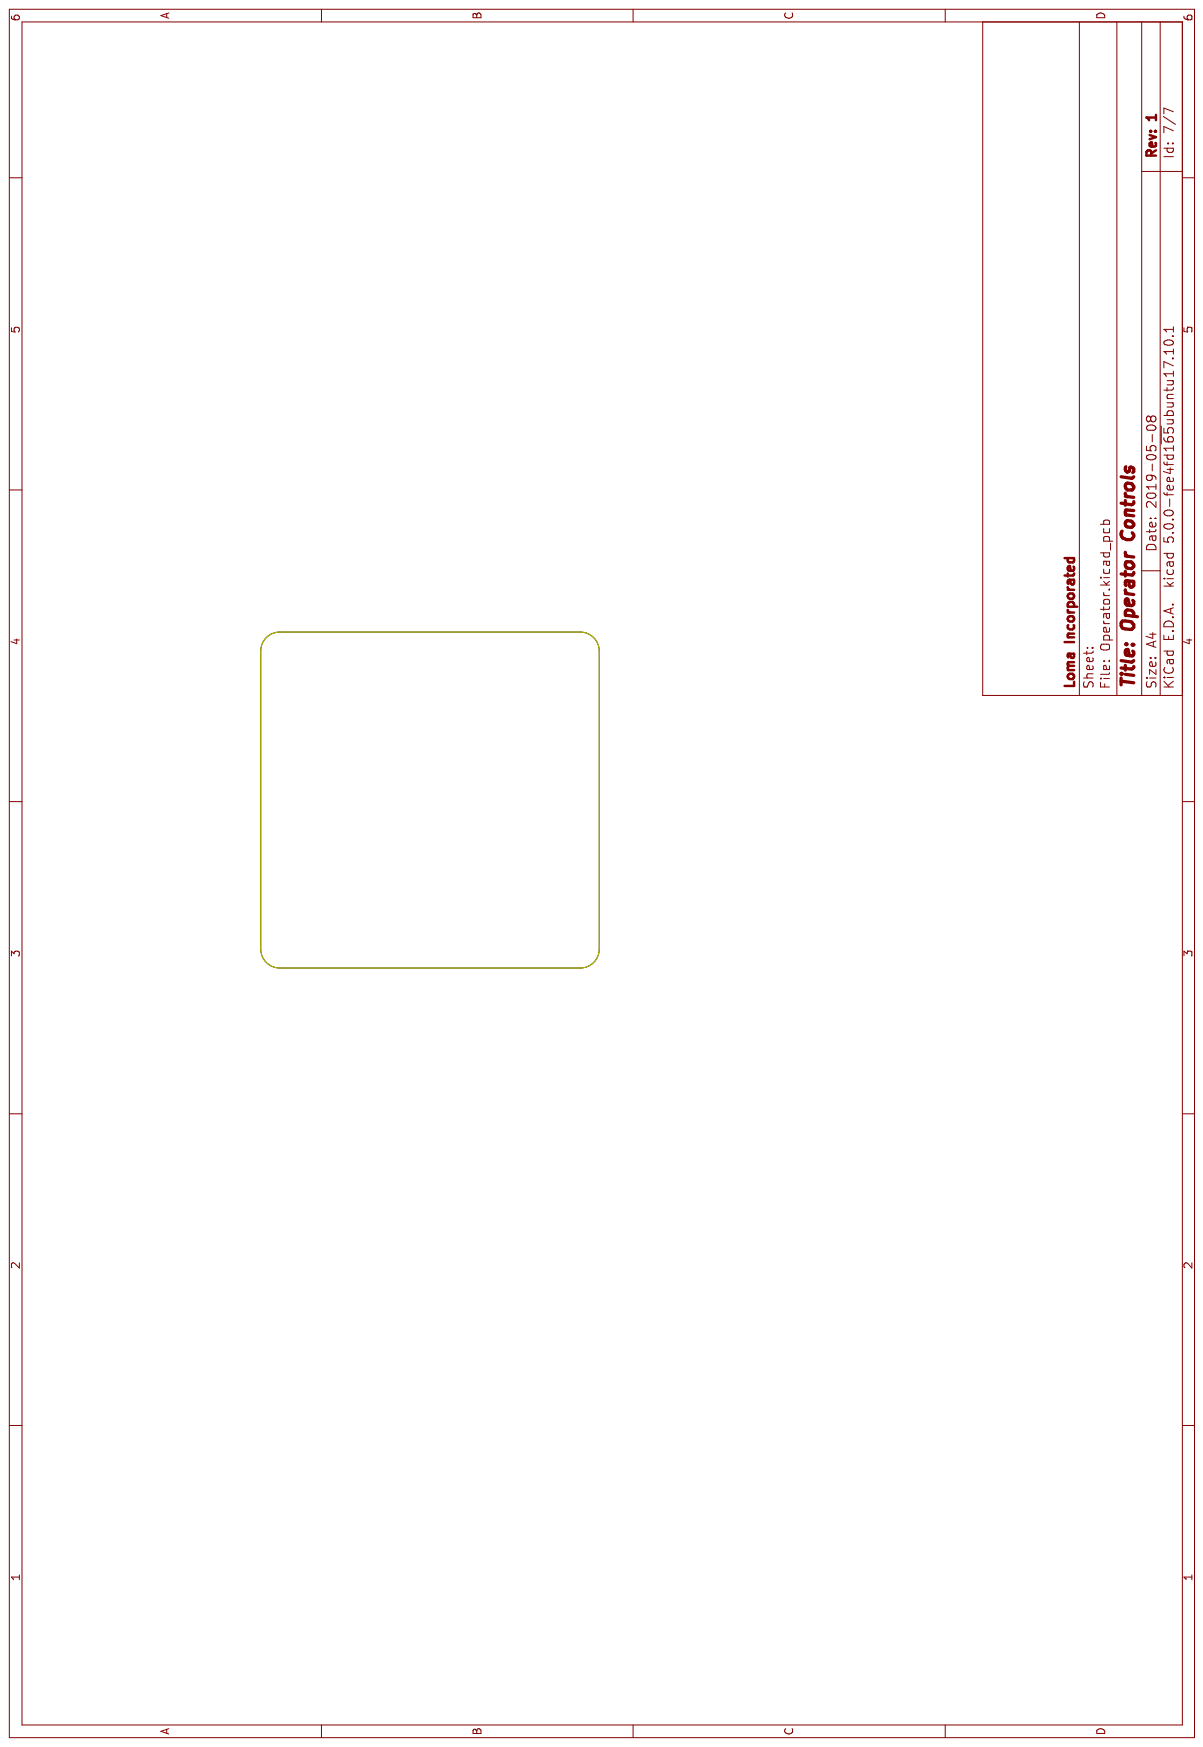
[picture p21: page 7]
