Rampagy/bldc/hardware/Operator/Documentation/Operator.pdf

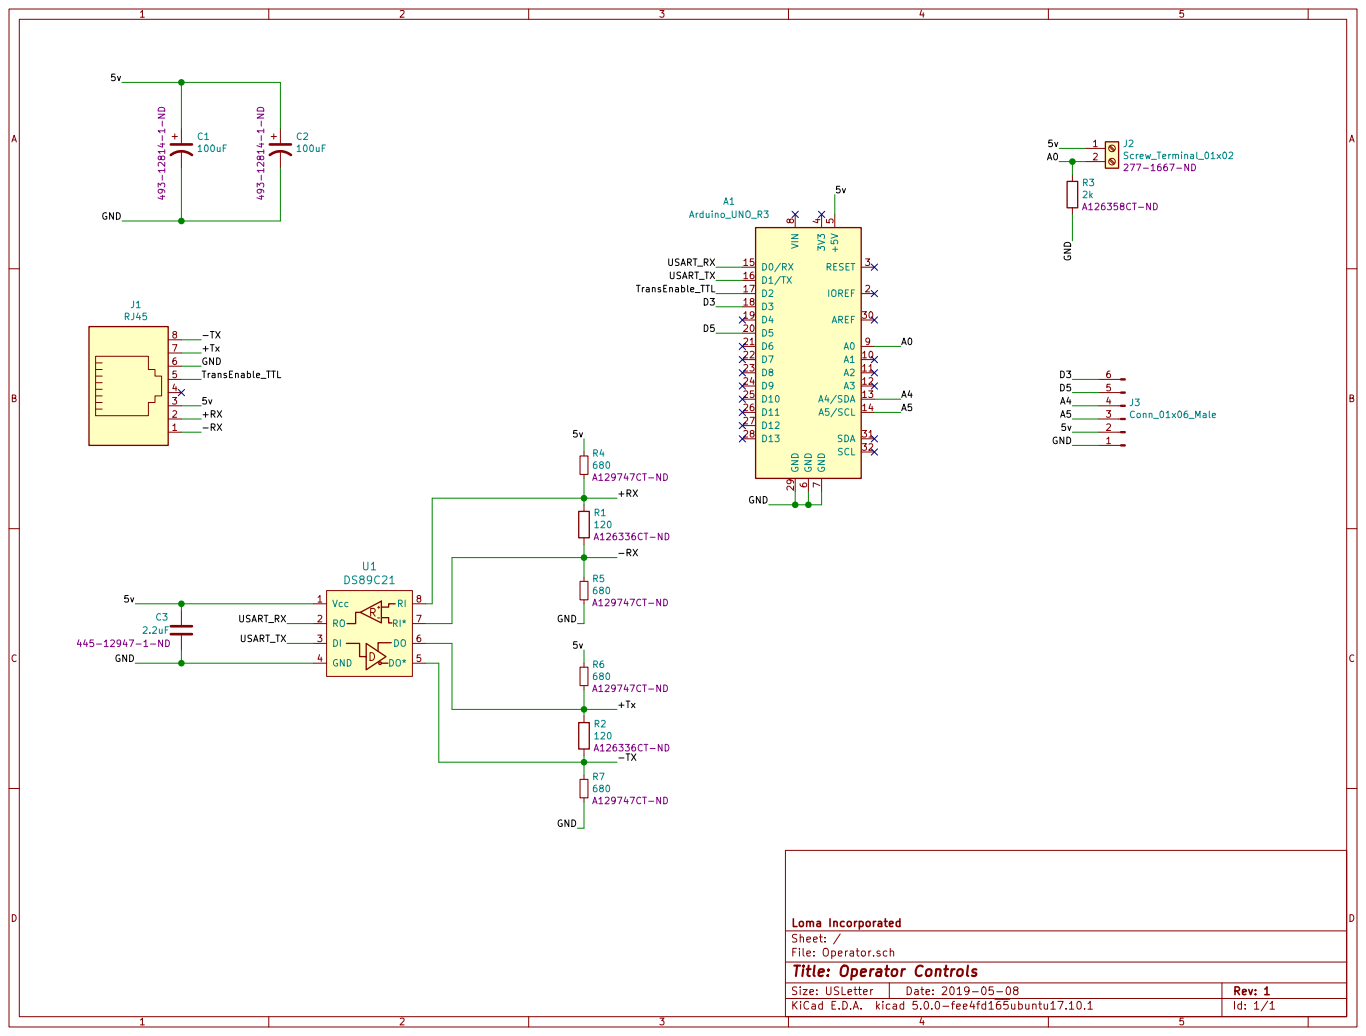
[picture p22: page 1]

File: Operator.sch Sheet: / Loma Incorporated

Id: 1/1 Title: Operator Controls
