Rampagy/bldc/hardware/Control/Documentation/board_expanded.pdf

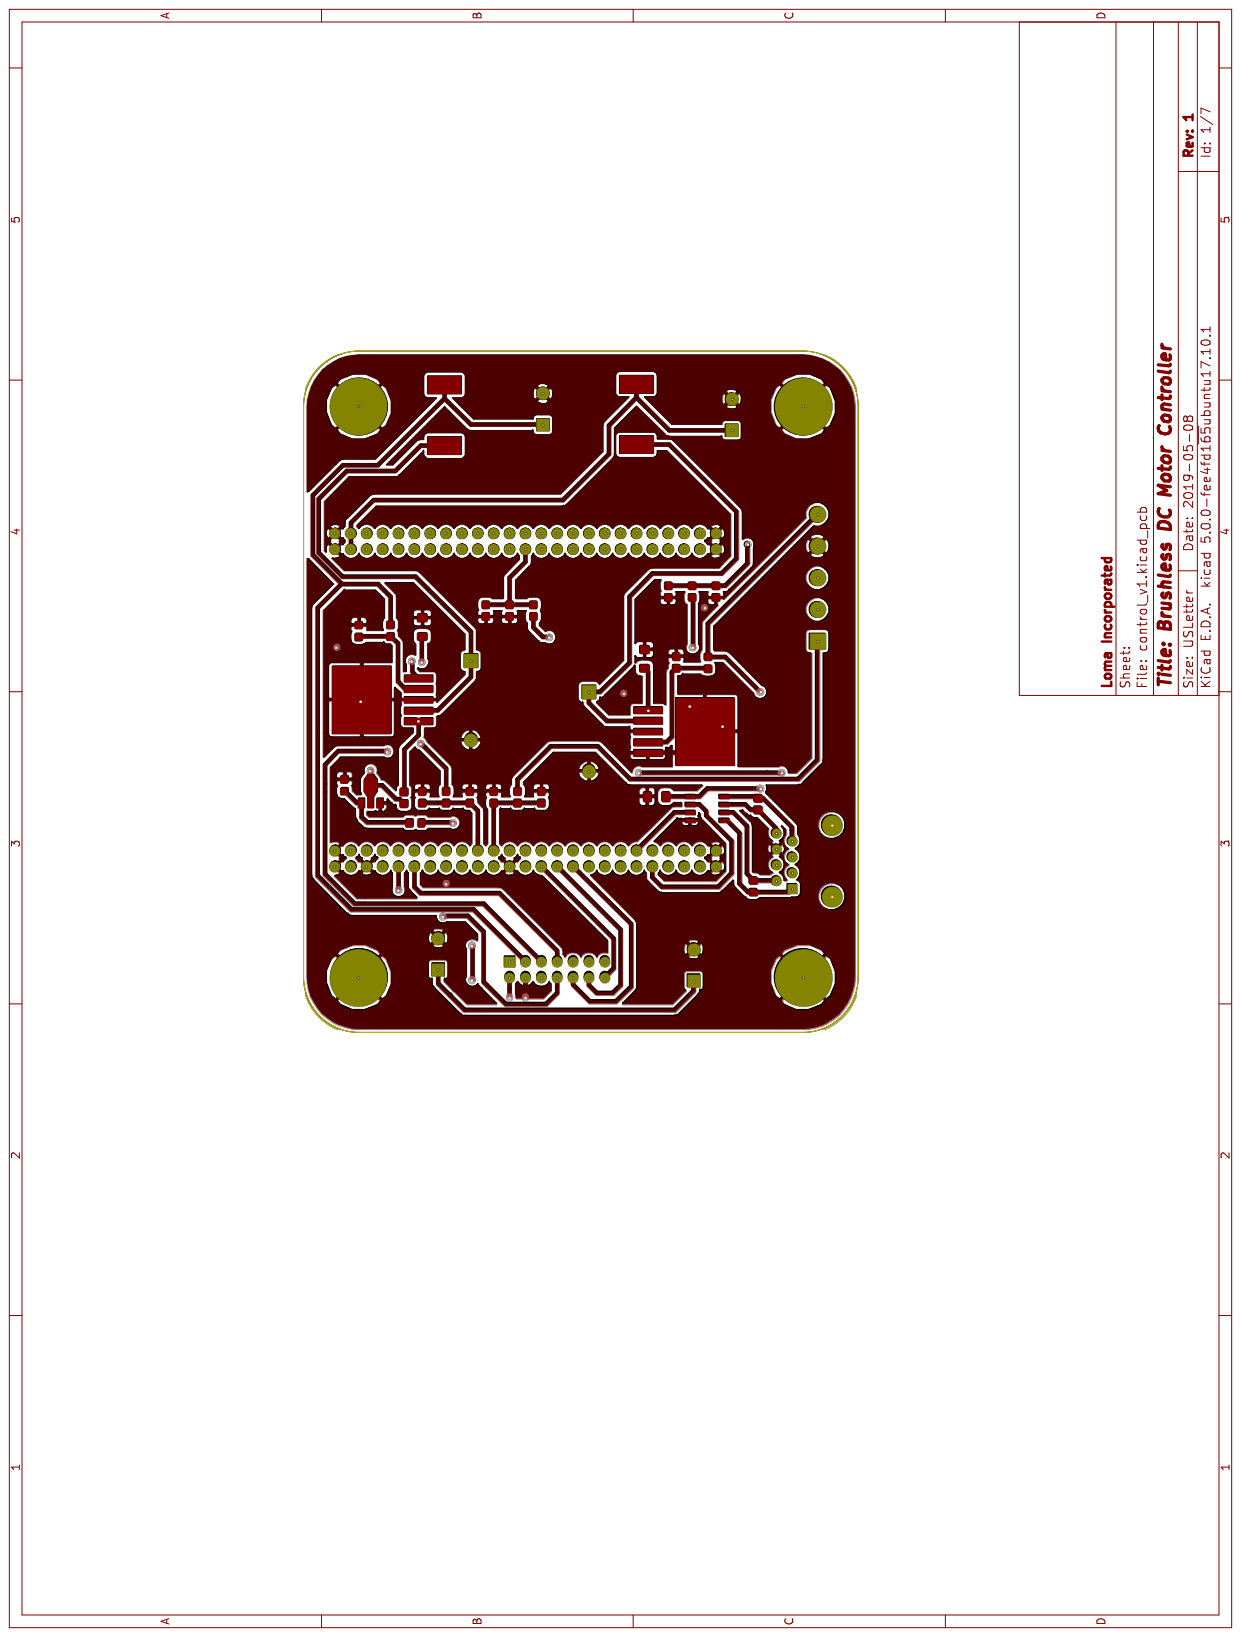
[picture p23: page 1]

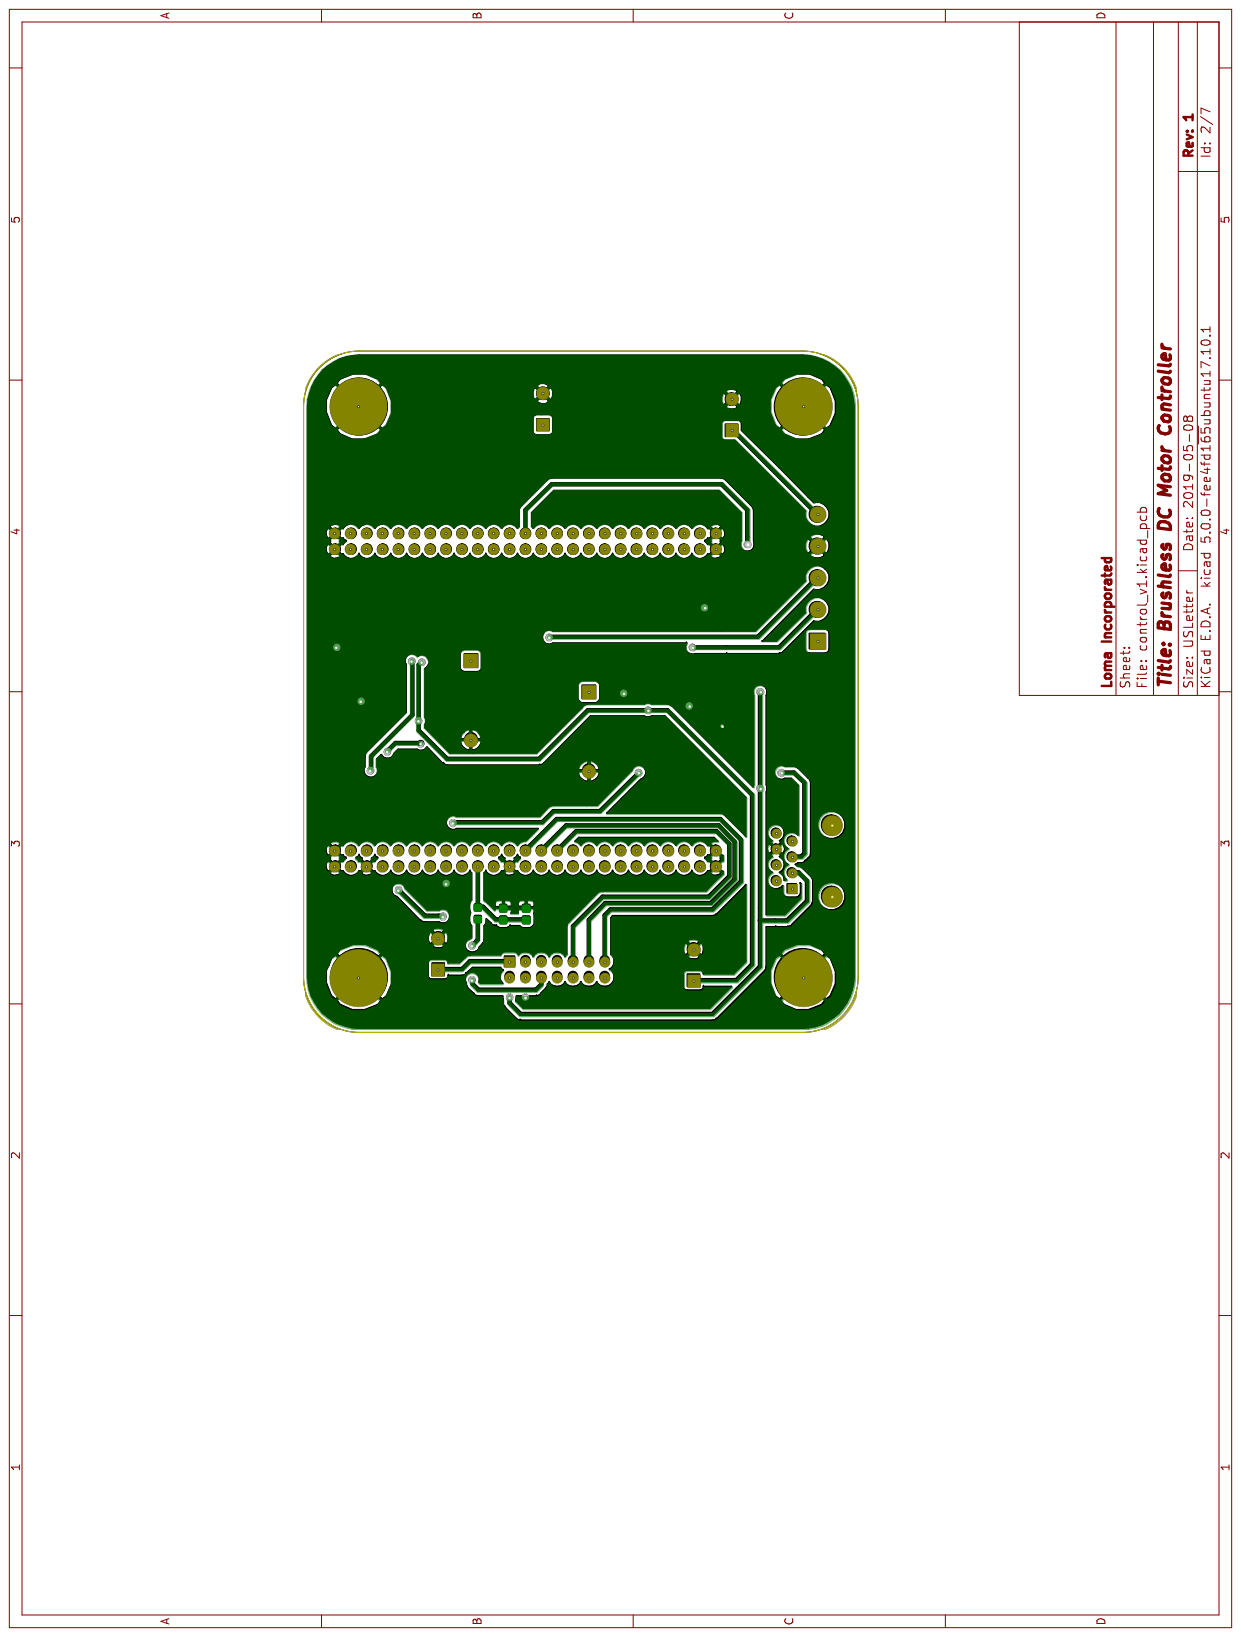
[picture p24: page 2]

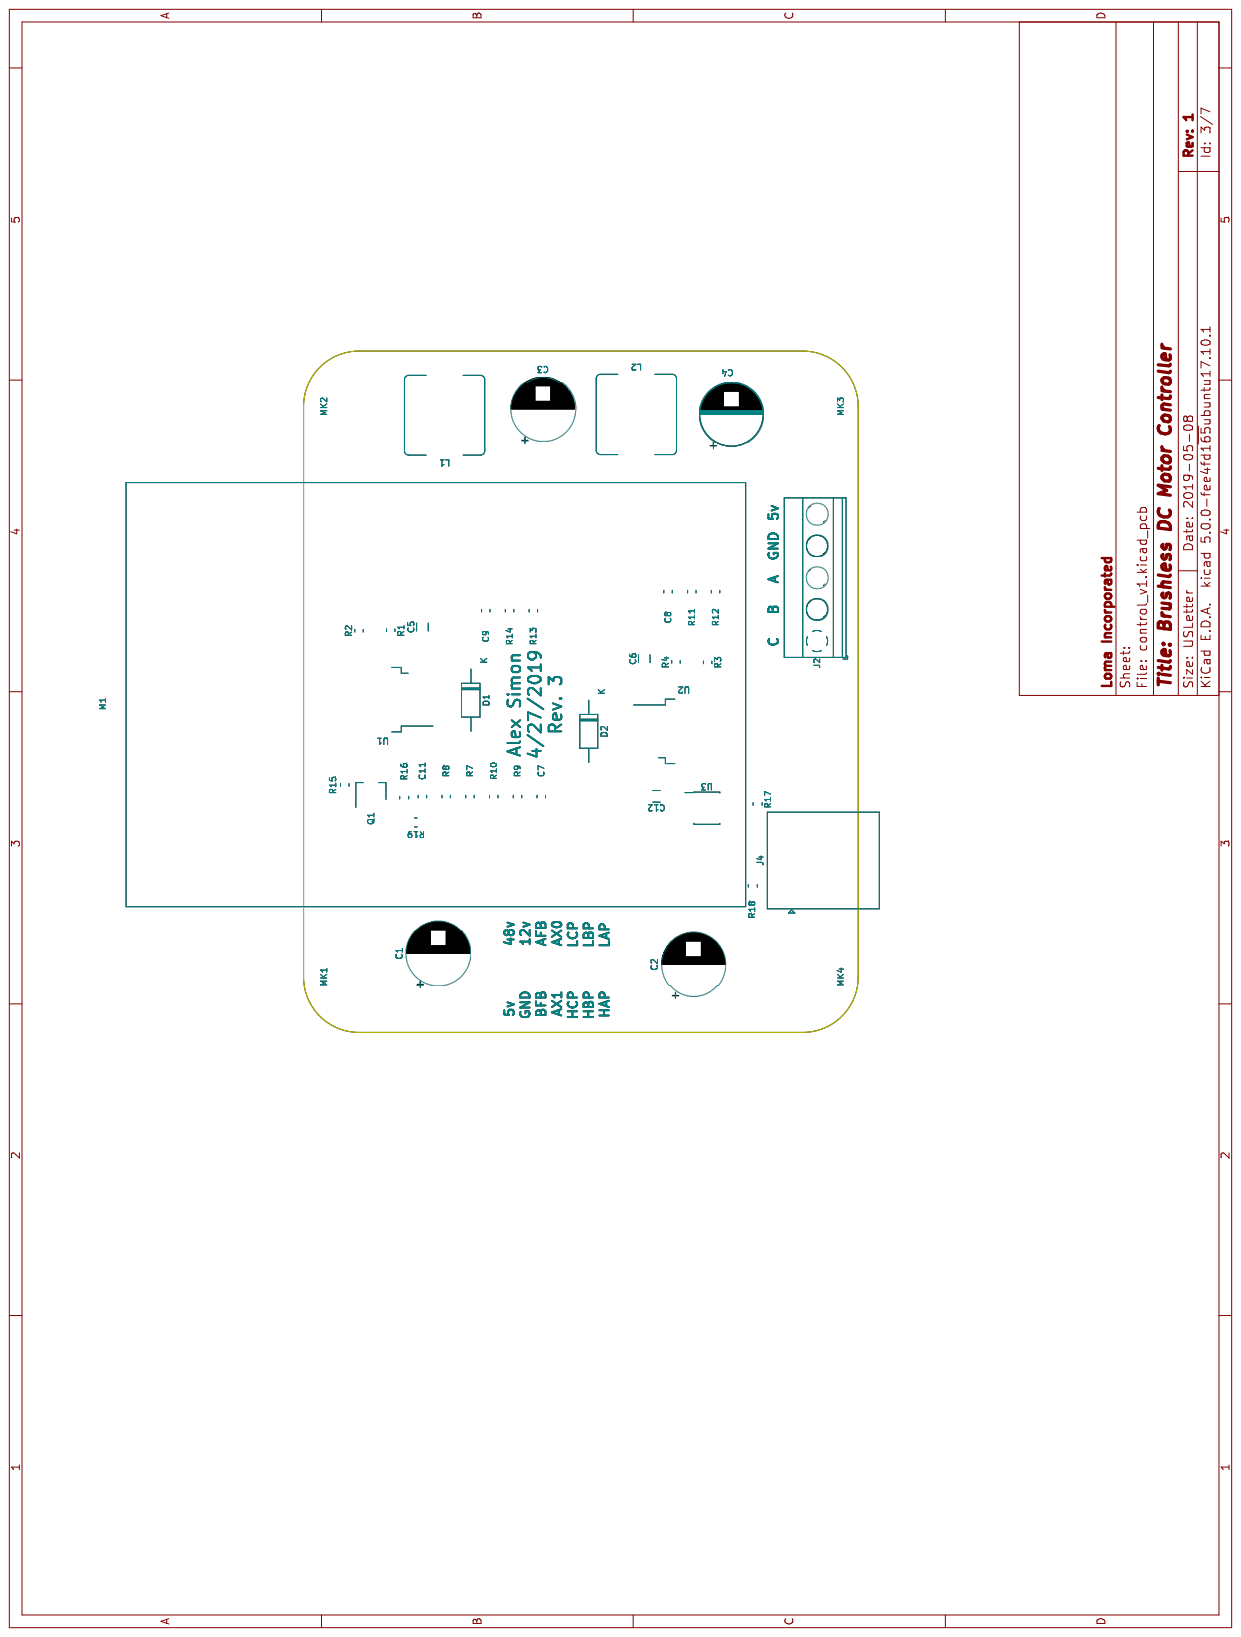
[picture p25: page 3]

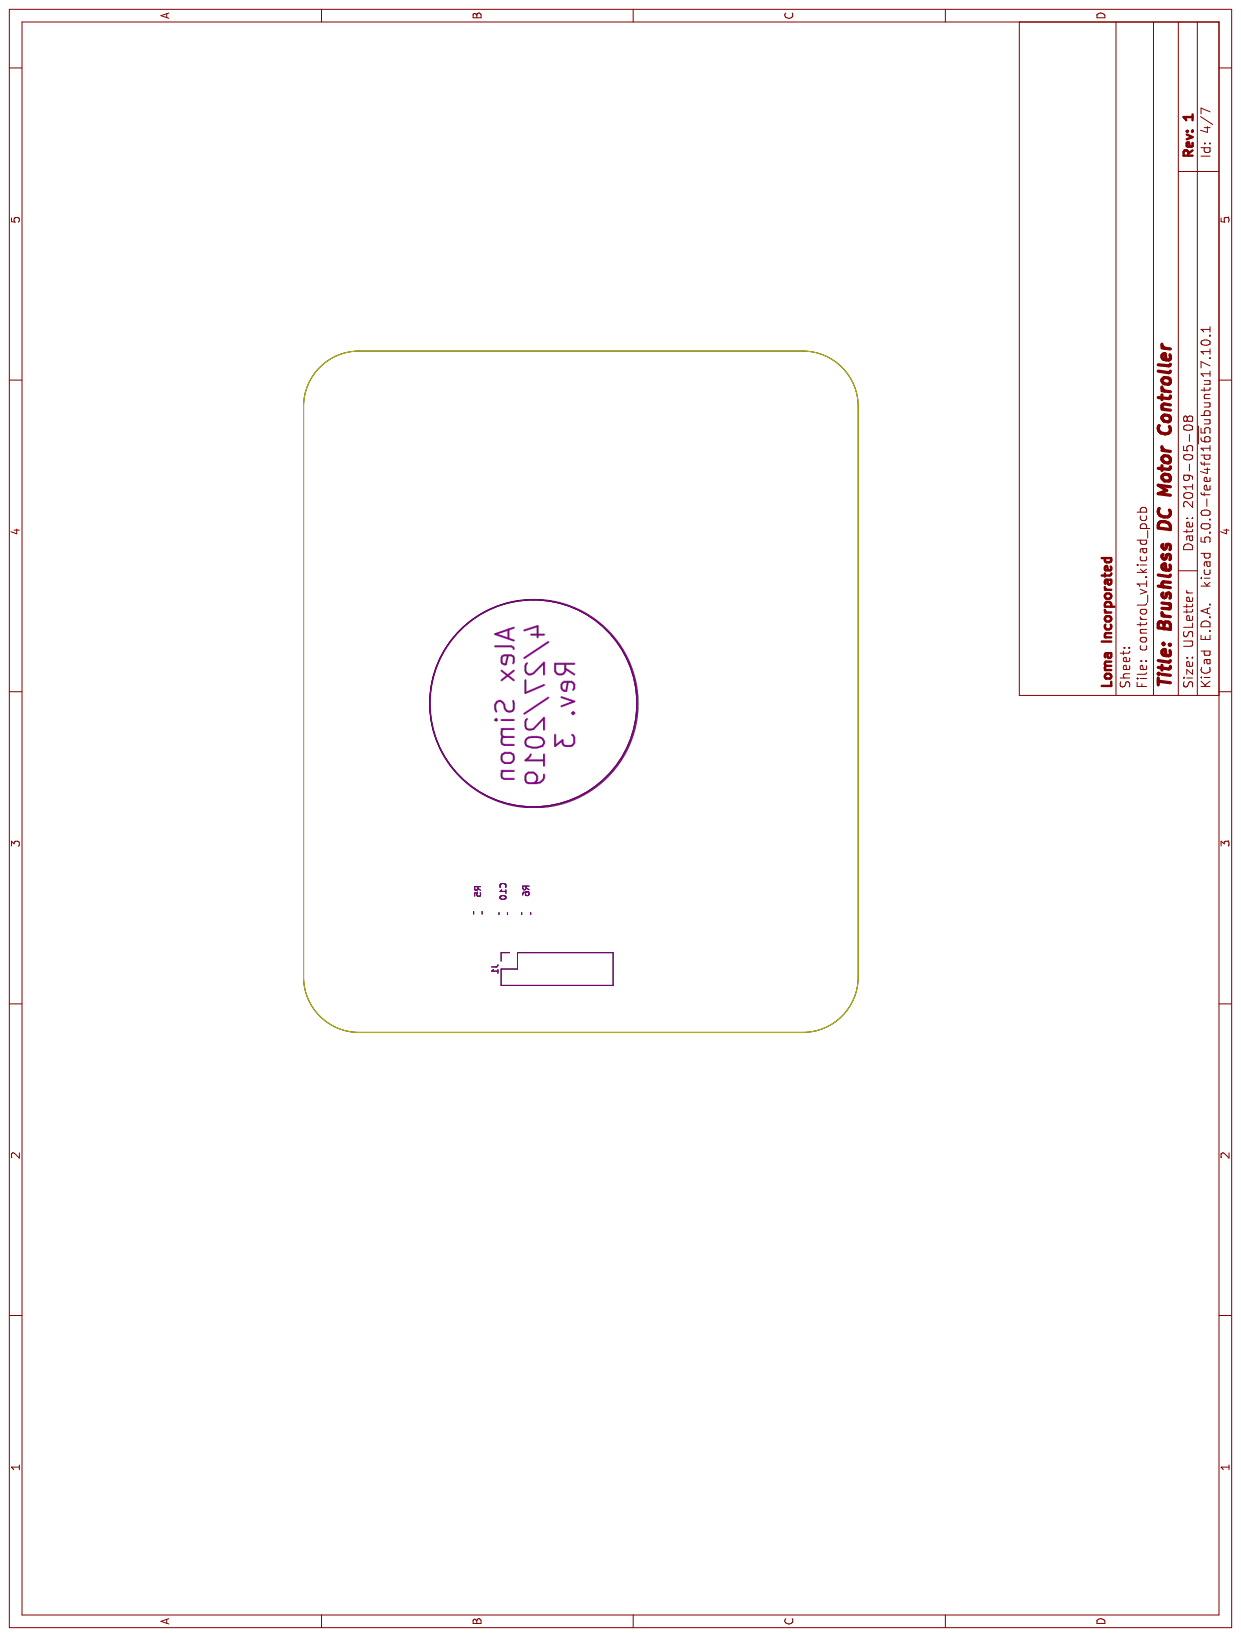
[picture p26: page 4]

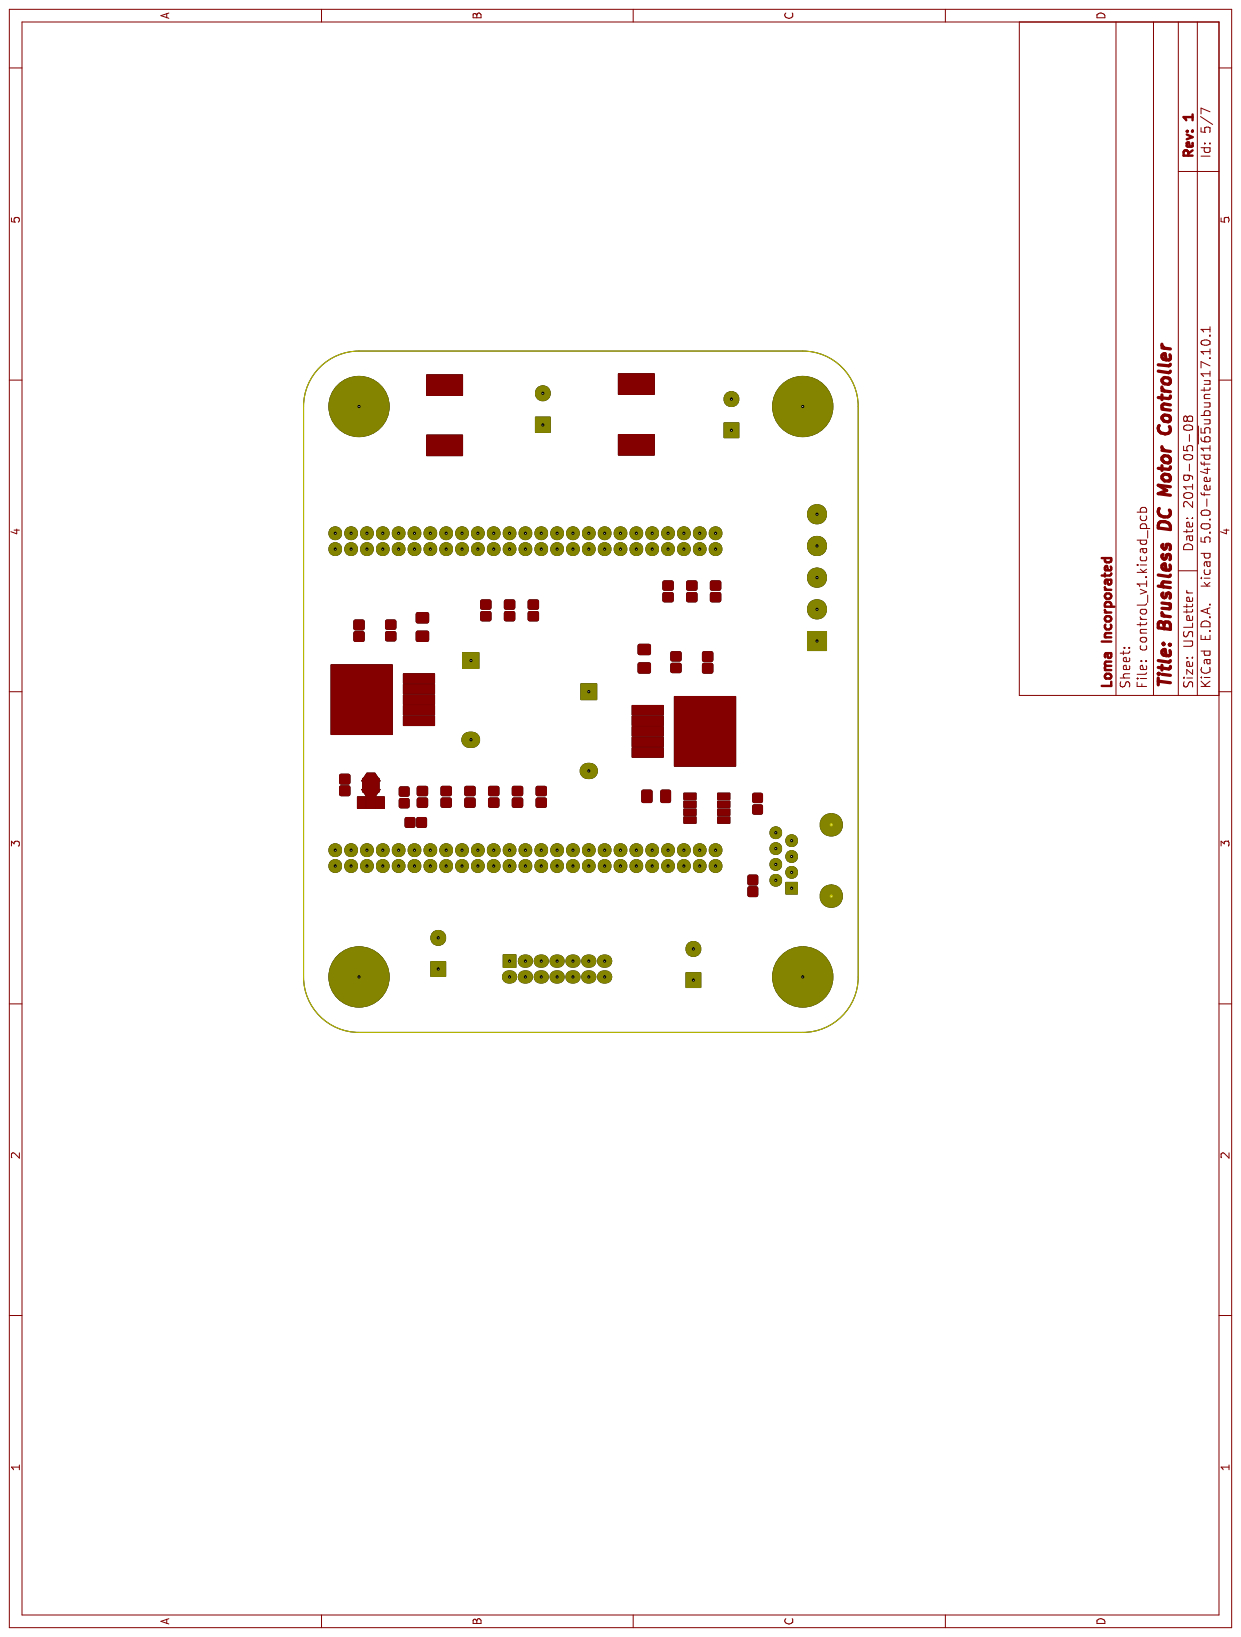
[picture p27: page 5]

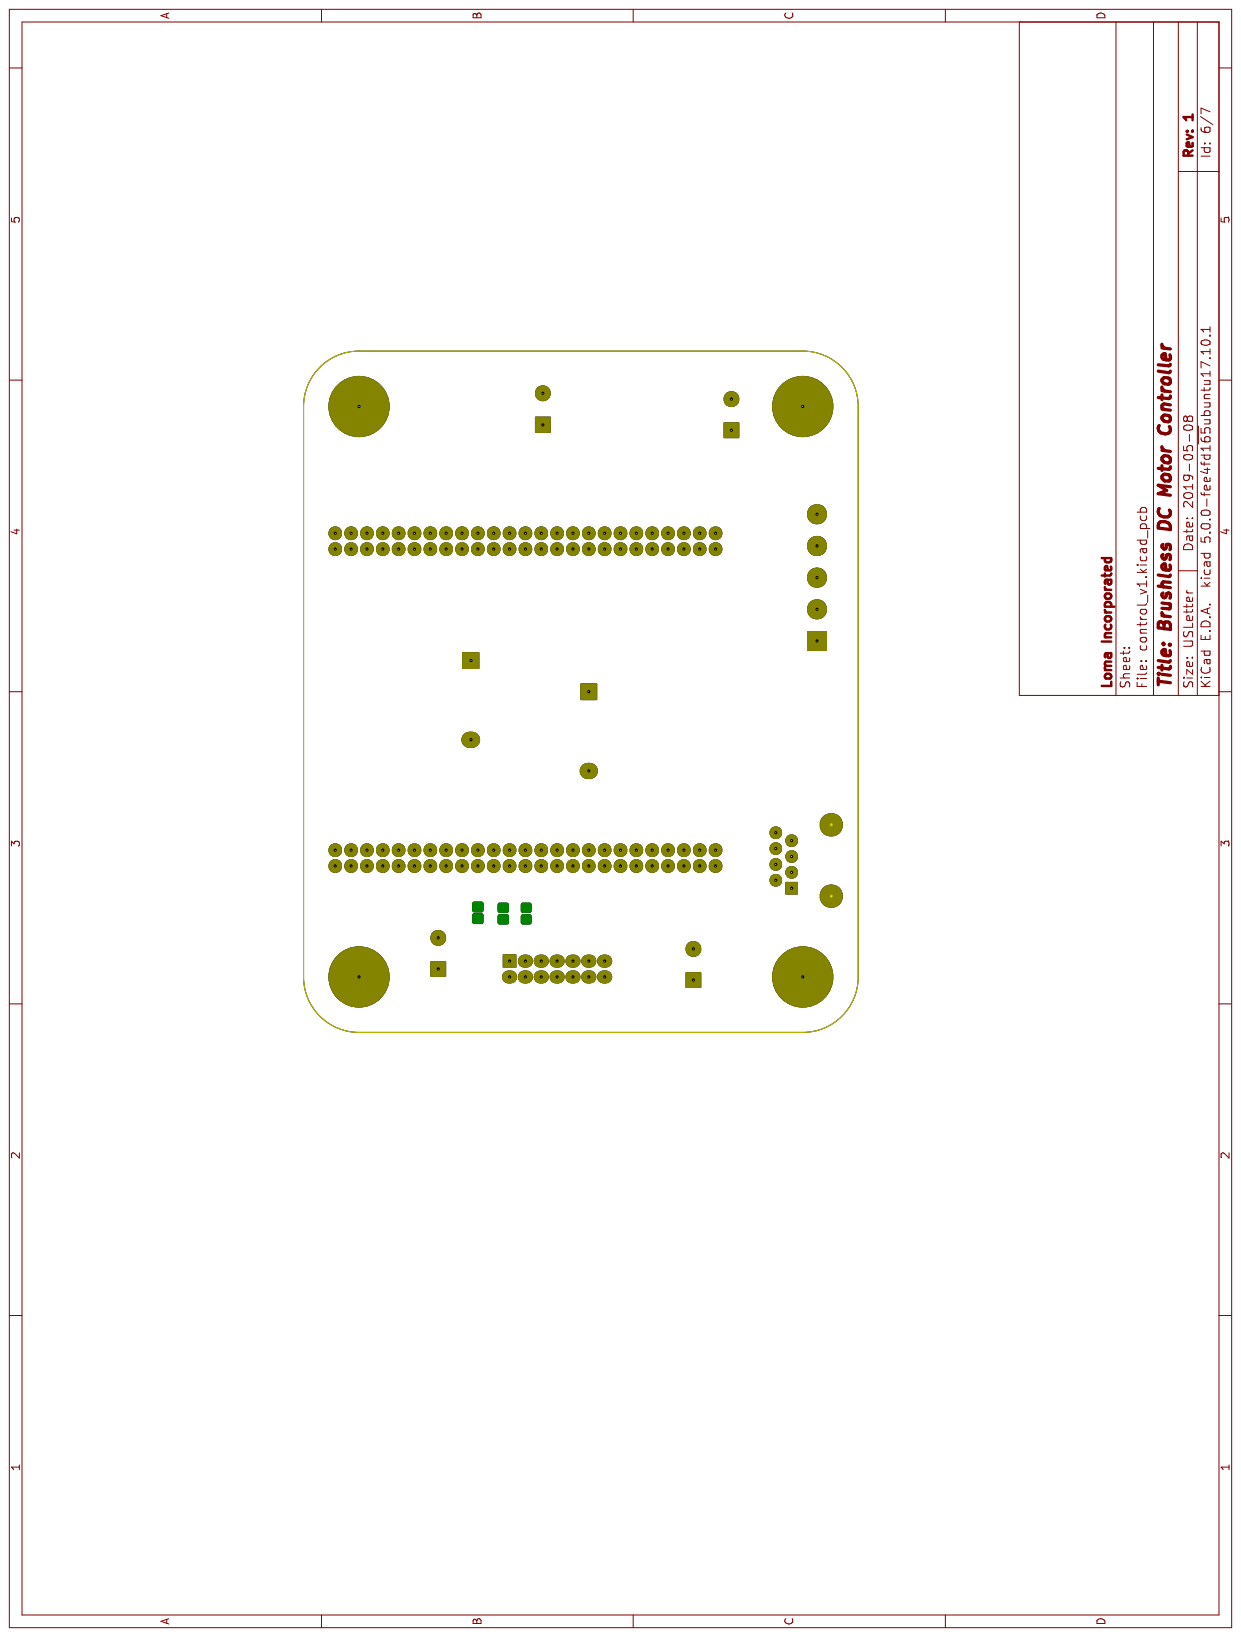
[picture p28: page 6]

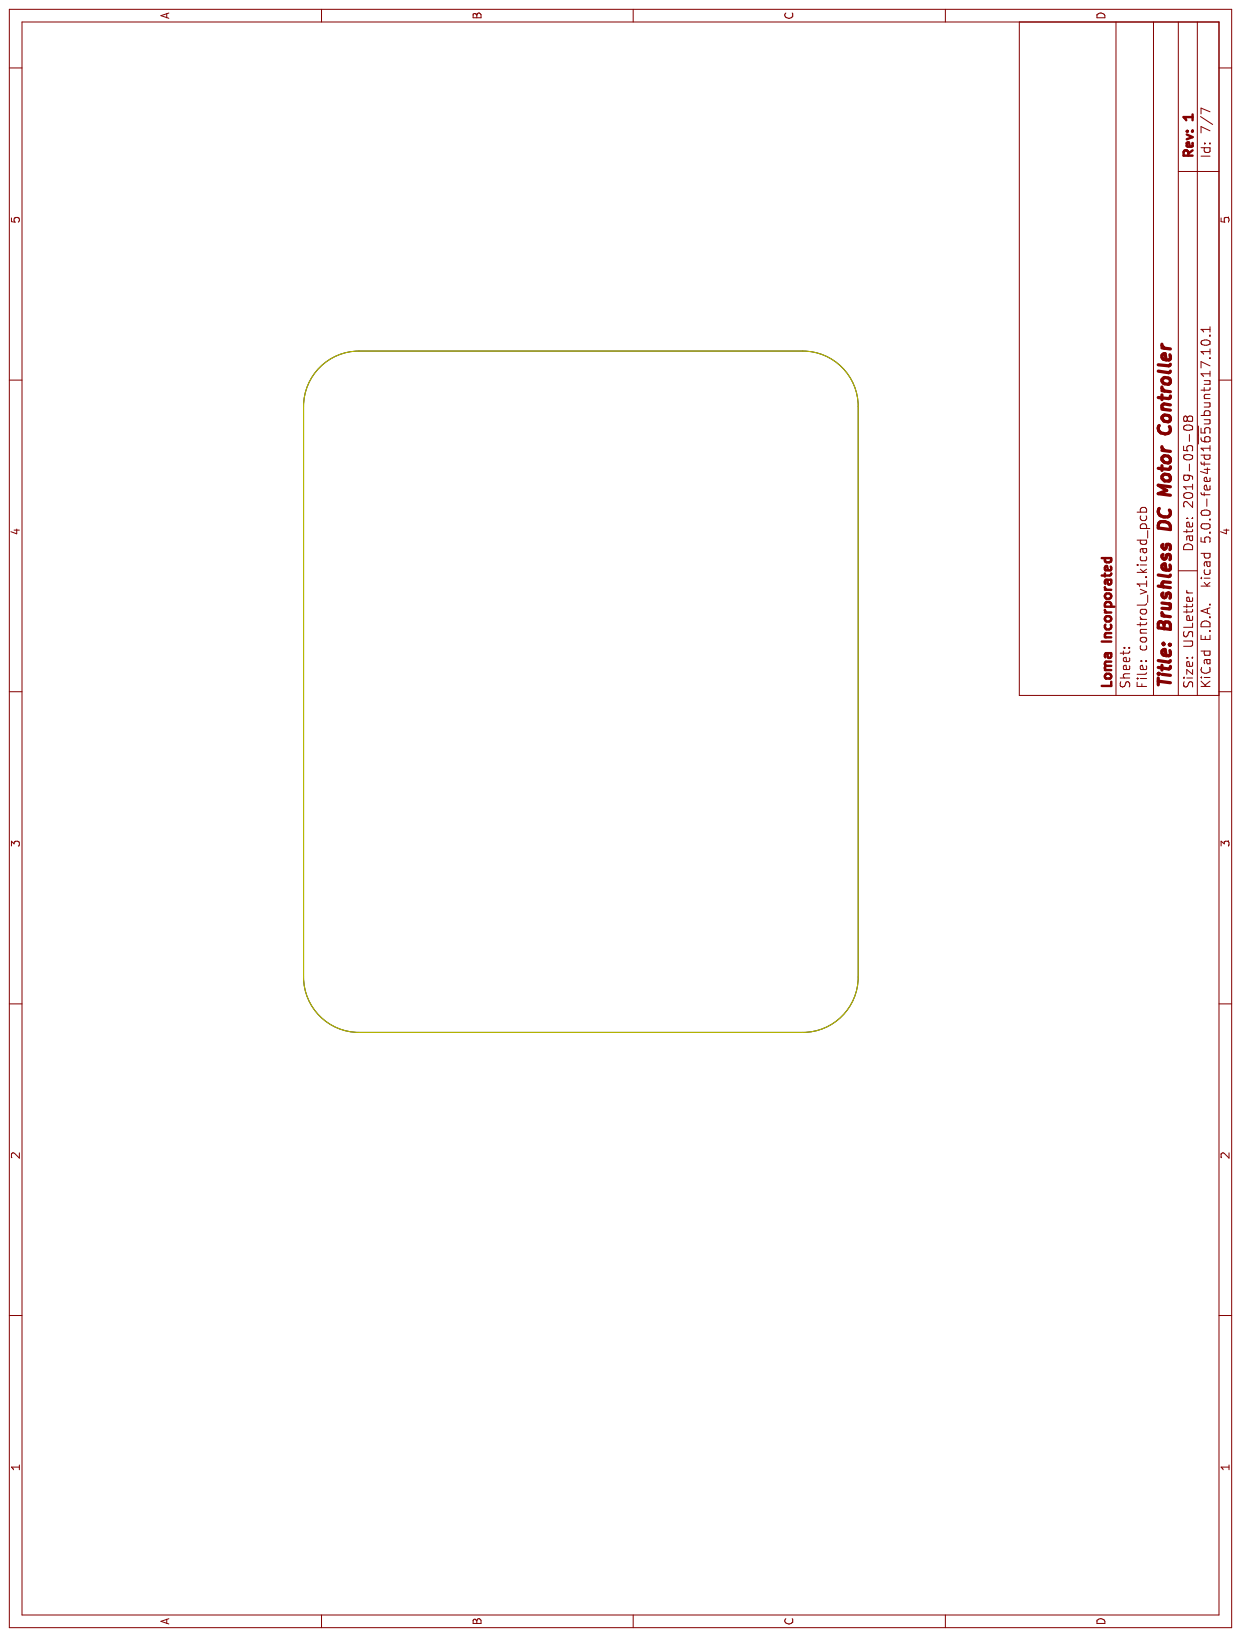
[picture p29: page 7]
