Rampagy/bldc/hardware/Power/bldc_v1.kicad_pcb

## KiCad design hardware/Power/bldc_v1.kicad_pcb (2019-10-25)

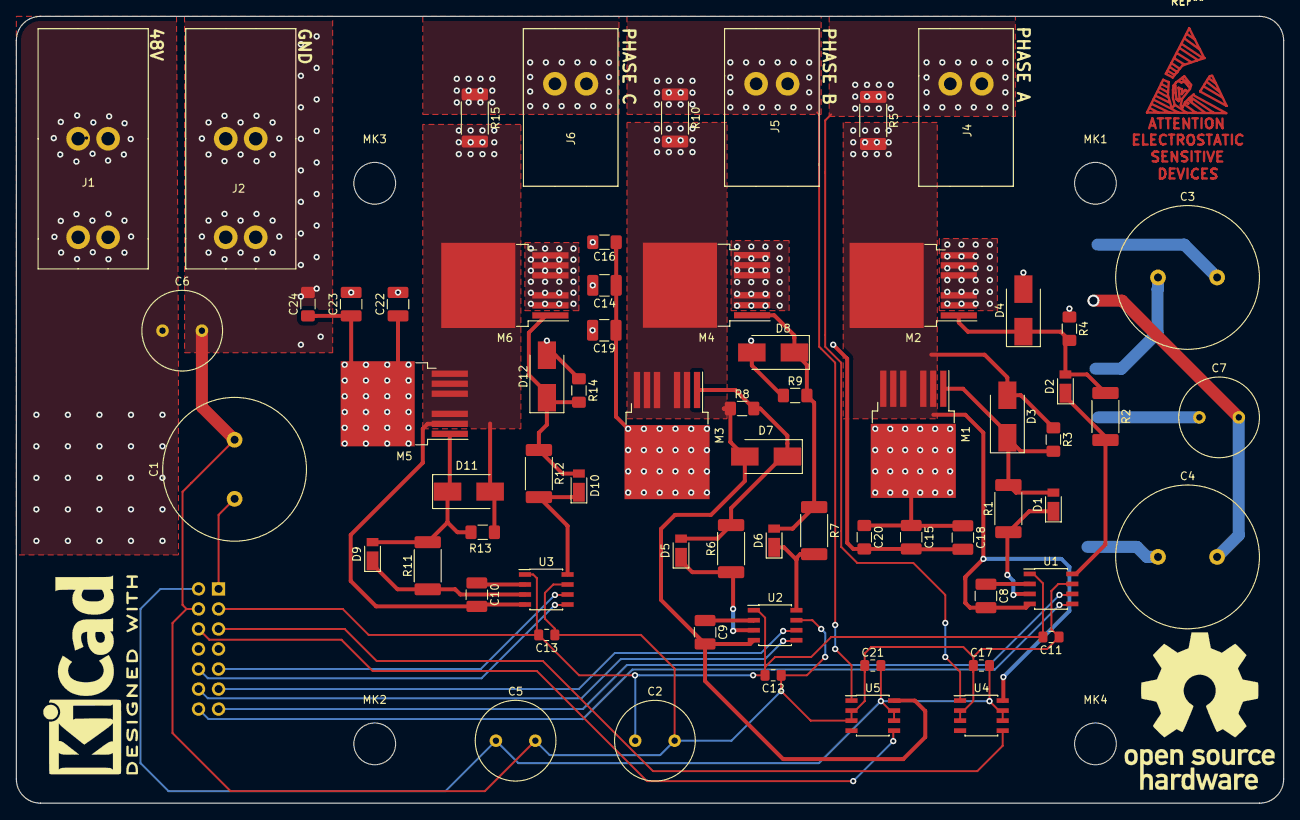
[picture p30: board bldc_v1.kicad_pcb from above]

Board: 2 copper layers, 160.8 x 99.8 mm, 72 parts (1 on the bottom side), 33 nets.

Parts:
C1, C3, C4: 680uF; C_Radial_D18.0mm_H35.5mm_P7.50mm
C2, C5, C6, C7: 100uF; C_Radial_D10.0mm_H20.0mm_P5.00mm
C8, C9, C10: 0.68u; C_1210_3225Metric_Pad1.42x2.65mm_HandSolder
C11, C12, C13: 10.0u; C_0805_2012Metric_Pad1.15x1.40mm_HandSolder
C14, C15, C18, C19, C22, C23: 4.7uF; C_1210_3225Metric_Pad1.42x2.65mm_HandSolder
C16, C20, C24: 2.2uF; C_1206_3216Metric_Pad1.42x1.75mm_HandSolder
C17, C21: 10.0uF; R_0805_2012Metric_Pad1.15x1.40mm_HandSolder
D1, D2, D5, D6, D9, D10: DFLS1100DICT-ND; D_PowerDI-123
D3, D4, D7, D8, D11, D12: SMBJ14A-FDICT-ND; D_SMB_Handsoldering
J1, J2: Screw_Terminal_01x01; Weidmuller 85amps
J3: Conn_02x07_Counter_Clockwise; PinHeader_2x07_P2.54mm_Vertical
J4, J5, J6: Screw_Terminal_01x01; Pheonix 65amps
M1, M2, M3, M4, M5, M6: IPB017N10N5; TO-263-6
MK1, MK2, MK3, MK4: Mounting_Hole; MountingHole_5.3mm_M5_DIN965
R1, R2, R6, R7, R11, R12: 10; R_2512_6332Metric_Pad1.52x3.35mm_HandSolder
R3, R4, R8, R9, R13, R14: 20k; R_1206_3216Metric_Pad1.42x1.75mm_HandSolder
R5, R10, R15: 0.001; R_2512_6332Metric_Pad1.52x3.35mm_HandSolder
U1, U2, U3: UCC27211A; SOIC-8_3.9x4.9mm_P1.27mm
U4, U5: AD8410; SOIC-8_3.9x4.9mm_P1.27mm

Connections:
/5v: C5.1, C17.2, C21.2, J3.2, U4.6, U4.7, U5.6, U5.7
/12v: C2.1, C11.2, C12.2, C13.2, J3.3, U1.1, U2.1, U3.1
/48v: C1.1, C3.1, C4.1, C6.1, C7.1, C14.1, C15.1, C16.1, C18.1, C19.1, C20.1, C22.1, C23.1, C24.1, J1.1, J3.1, M1.4, M3.4, M5.4
/GND: C1.2, C2.2, C3.2, C4.2, C5.2, C6.2, C7.2, C11.1, C12.1, C13.1, C14.2, C15.2, C16.2, C17.1, C18.2, C19.2, C20.2, C21.1, C22.2, C23.2, C24.2, D4.2, D8.2, D12.2, J2.1, J3.4, M2.2, M2.3, M2.5, M2.6, M2.7, M4.2, M4.3, M4.5, M4.6, M4.7, M6.2, M6.3, M6.5, M6.6, M6.7, R4.1, R9.1, R14.1, U1.7, U2.7, U3.7, U4.2, U4.3, U5.2, U5.3
/HS_A_TTL_PWM: J3.14, U1.5
/HS_B_TTL_PWM: J3.12, U2.5
/HS_C_TTL_PWM: J3.10, U3.5
/LS_A_TTL_PWM: J3.13, U1.6
/LS_B_TTL_PWM: J3.11, U2.6
/LS_C_TTL_PWM: J3.9, U3.6
/PHASEA_FB: J3.5, U4.5
/PHASEB_FB: J3.6, U5.5
/PHASE_A: J4.1, R5.1, U4.1
/PHASE_B: J5.1, R10.1, U5.1
/PHASE_C: J6.1, R15.1
/gatedrivers/HO_A: D1.1, R1.2, U1.3
/gatedrivers/HO_B: D5.1, R6.2, U2.3
/gatedrivers/HO_C: D9.1, R11.2, U3.3
/gatedrivers/LO_A: D2.1, R2.2, U1.8
/gatedrivers/LO_B: D6.1, R7.2, U2.8
/gatedrivers/LO_C: D10.1, R12.2, U3.8
/gatedrivers/PHASEA_SOURCE: C8.2, D3.2, M1.2, M1.3, M1.5, M1.6, M1.7, M2.4, R3.1, R5.2, U1.4, U4.8
/gatedrivers/PHASEB_SOURCE: C9.2, D7.2, M3.2, M3.3, M3.5, M3.6, M3.7, M4.4, R8.1, R10.2, U2.4, U5.8
/gatedrivers/PHASEC_SOURCE: C10.2, D11.2, M5.2, M5.3, M5.5, M5.6, M5.7, M6.4, R13.1, R15.2, U3.4
/mosfets/HS_A_GATE: D1.2, D3.1, M1.1, R1.1, R3.2
unnamed: C8.1, U1.2
unnamed: C9.1, U2.2
unnamed: C10.1, U3.2
unnamed: D2.2, D4.1, M2.1, R2.1, R4.2
unnamed: D5.2, D7.1, M3.1, R6.1, R8.2
unnamed: D6.2, D8.1, M4.1, R7.1, R9.2
unnamed: D10.2, D12.1, M6.1, R12.1, R14.2
unnamed: D9.2, D11.1, M5.1, R11.1, R13.2
