Rampagy/bldc/hardware/Operator/Operator.kicad_pcb

## KiCad design hardware/Operator/Operator.kicad_pcb (2019-05-08)

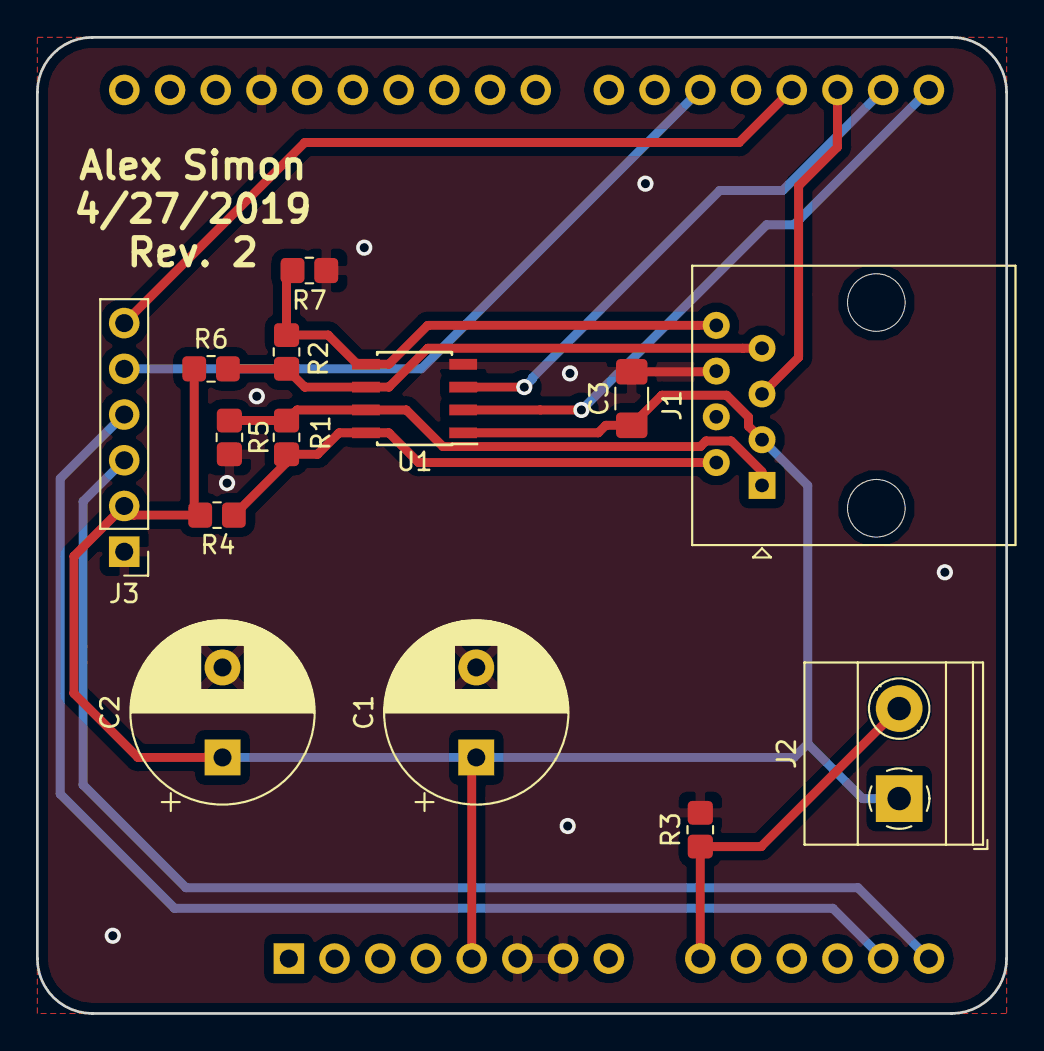
[picture p31: board Operator.kicad_pcb from above]

Board: 2 copper layers, 53.8 x 54.2 mm, 15 parts (1 on the bottom side), 14 nets.

Parts:
A1: Arduino_UNO_R3
C1, C2: 100uF; CP_Radial_D10.0mm_P5.00mm
C3: 2.2uF; C_1206_3216Metric_Pad1.42x1.75mm_HandSolder
J1: RJ45; RJ45_Amphenol_54602-x08_Horizontal
J2: Screw_Terminal_01x02; TerminalBlock_Phoenix_MKDS-1,5-2_1x02_P5.00mm_Horizontal
J3: Conn_01x06_Male; PinHeader_1x06_P2.54mm_Vertical
R1, R2: 120; R_0805_2012Metric_Pad1.33x1.40mm_HandSolder
R3: 2k; R_0805_2012Metric_Pad1.33x1.40mm_HandSolder
R4, R5, R6, R7: 680; R_0805_2012Metric_Pad1.33x1.40mm_HandSolder
U1: DS89C21; SOIC-8_3.9x4.9mm_P1.27mm

Connections:
/5v: A1.5, C1.1, C2.1, C3.1, J1.3, J2.1, J3.2, R4.1, R6.1, U1.1
/+RX: J1.2, R1.1, R4.2, U1.8
/+Tx: J1.7, R2.1, R6.2, U1.6
/-RX: J1.1, R1.2, R5.1, U1.7
/-TX: J1.8, R2.2, R7.1, U1.5
/A0: A1.9, J2.2, R3.1
/A4: A1.13, J3.4
/A5: A1.14, J3.3
/D3: A1.18, J3.6
/D5: A1.20, J3.5
/GND: A1.6, A1.7, A1.29, C1.2, C2.2, C3.2, J1.6, J3.1, R3.2, R5.2, R7.2, U1.4
/TransEnable_TTL: A1.17, J1.5
/USART_RX: A1.15, U1.2
/USART_TX: A1.16, U1.3
