Rampagy/bldc/hardware/Control/control_v1.kicad_pcb

## KiCad design hardware/Control/control_v1.kicad_pcb (2019-05-08)

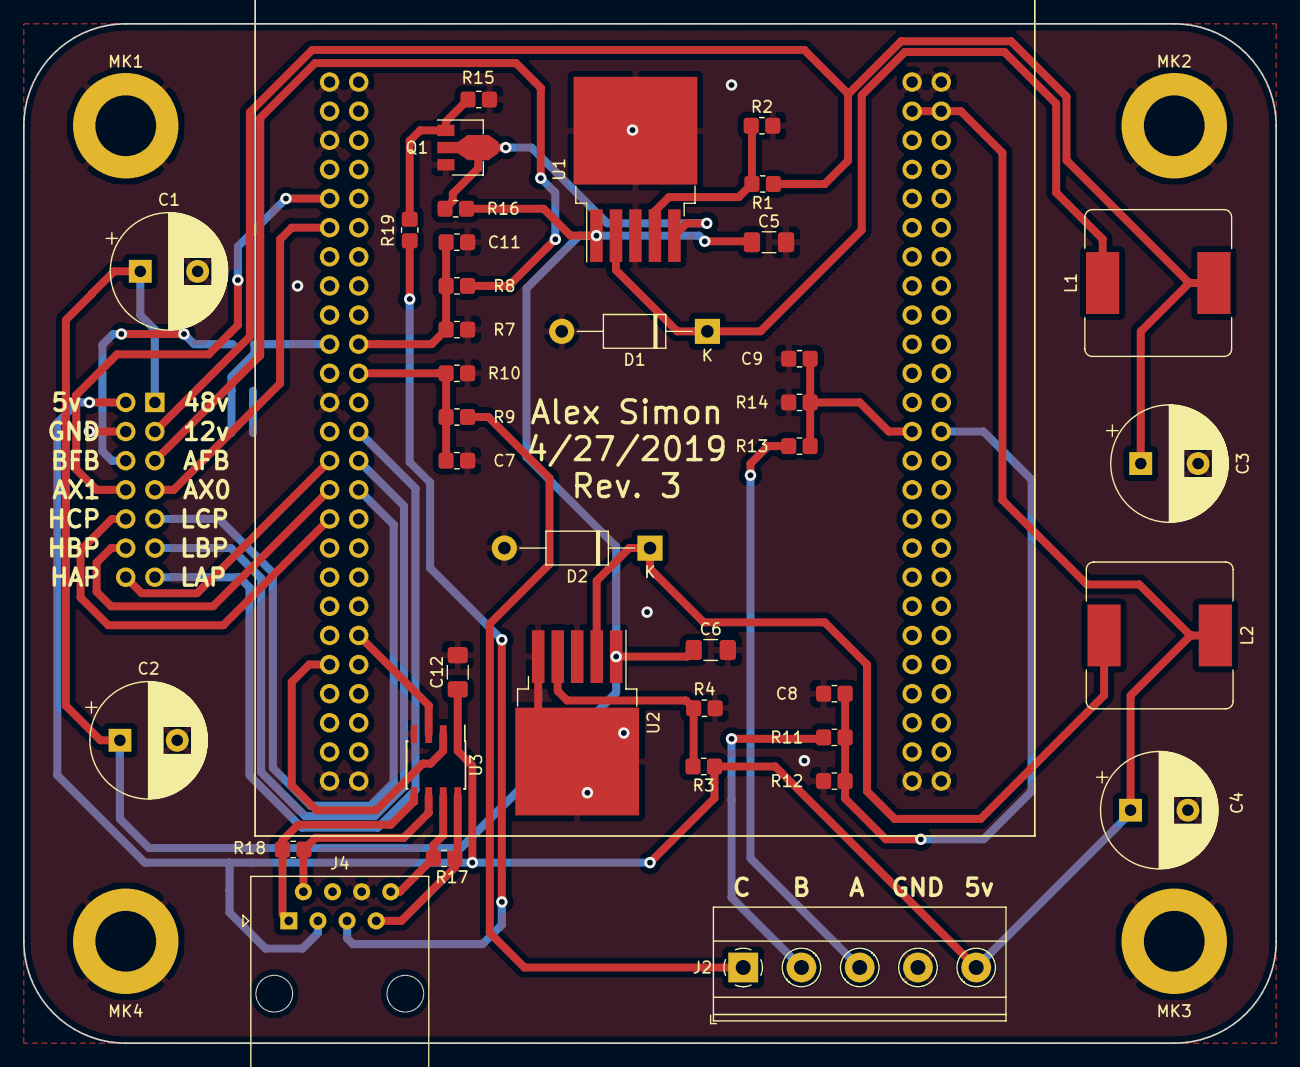
[picture p32: board control_v1.kicad_pcb from above]

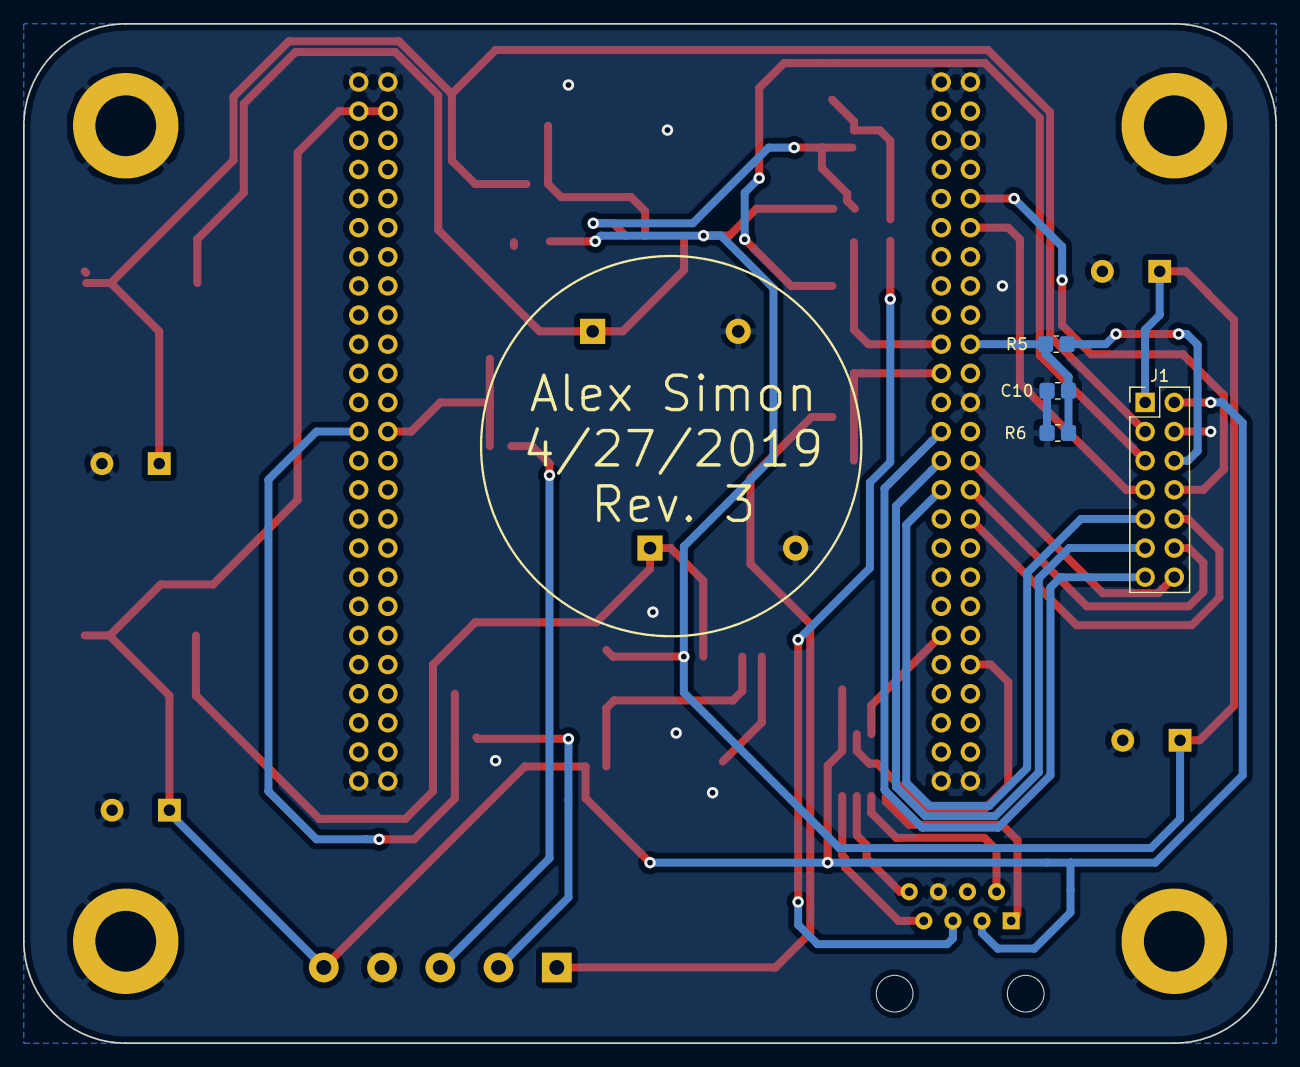
[picture p33: board control_v1.kicad_pcb from below]

Board: 2 copper layers, 109.2 x 88.9 mm, 47 parts (4 on the bottom side), 35 nets.

Parts:
C1, C2: 100uF; CP_Radial_D10.0mm_P5.00mm
C3: 330uF; CP_Radial_D10.0mm_P5.00mm
C4: 1.2mF; CP_Radial_D10.0mm_P5.00mm
C5, C6, C12: 2.2uF; C_1206_3216Metric_Pad1.42x1.75mm_HandSolder
C7, C8, C9, C10, C11: 2.2nF; C_0805_2012Metric_Pad1.33x1.40mm_HandSolder
D1, D2: 1N5819; D_DO-41_SOD81_P12.70mm_Horizontal
J1: Conn_02x07_Counter_Clockwise; PinHeader_2x07_P2.54mm_Vertical
J2: Screw_Terminal_01x05; TerminalBlock_Phoenix_MKDS-1,5-5-5.08_1x05_P5.08mm_Horizont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
J4: RJ45; RJ45_Amphenol_54602-x08_Horizontal
L1: 680uH; L_Bourns_SRR1260
L2: 330uH; L_Bourns_SRR1260
M1: STM32F4-DISCOVERY; STM32-F4-DISCOVERY
MK1, MK2, MK3, MK4: Mounting_Hole; MountingHole_5.3mm_M5_DIN965_Pad
Q1: BCX56; SOT-89-3
R1, R9, R11, R13, R16: 18k; R_0805_2012Metric_Pad1.33x1.40mm_HandSolder
R2, R4: 2k; R_0805_2012Metric_Pad1.33x1.40mm_HandSolder
R3, R15: 6k; R_0805_2012Metric_Pad1.33x1.40mm_HandSolder
R5, R8, R19: 680; R_0805_2012Metric_Pad1.33x1.40mm_HandSolder
R6, R7: 2.0k; R_0805_2012Metric_Pad1.33x1.40mm_HandSolder
R10, R12, R14: 30k; R_0805_2012Metric_Pad1.33x1.40mm_HandSolder
R17, R18: 120; R_0805_2012Metric_Pad1.33x1.40mm_HandSolder
U1, U2: TL2575HV-ADJ; TO-263-5_TabPin3
U3: DS89C21; SOIC-8_3.9x4.9mm_P1.27mm

Connections:
/5v: C4.1, C12.1, J1.2, J2.5, J4.3, L2.2, M1.53, M1.54, R3.1, U3.1
/12v: C3.1, J1.3, L1.2, R1.1
/48v: C1.1, C2.1, C5.1, C6.1, J1.1, R16.1, U1.1, U2.1
/+RX: J4.7, R17.1, U3.8
/+TX: J4.2, R18.1, U3.6
/-RX: J4.8, R17.2, U3.7
/-TX: J4.1, R18.2, U3.5
/AUX_0: J1.7, M1.11
/AUX_1: J1.8, M1.9
/GND: C1.2, C2.2, C3.2, C4.2, C5.2, C6.2, C7.2, C8.2, C9.2, C10.2, C11.2, C12.2, D1.2, D2.2, J1.4, J2.4, J4.6, M1.1, M1.2, M1.5, M1.23, M1.49, M1.50, M1.51, M1.52, M1.99, M1.100, MK1.1, MK2.1, MK3.1, MK4.1, Q1.3, R2.2, R4.2, R6.2, R7.2, R10.2, R12.2, R14.2, R15.2, U1.3, U2.3, U2.5, U3.4
/HALL_A: J2.3, R13.2
/HALL_B: J2.2, R11.2
/HALL_C: J2.1, R9.2
/HS_A_TTL_PWM: J1.14, M1.27
/HS_B_TTL_PWM: J1.12, M1.29
/HS_C_TTL_PWM: J1.10, M1.31
/LS_A_TTL_PWM: J1.13, M1.26
/LS_B_TTL_PWM: J1.11, M1.28
/LS_C_TTL_PWM: J1.9, M1.30
/PHASEA_FB: J1.5, R8.1
/PHASEB_FB: J1.6, R5.1
/TransEnable_TTL: J4.5, R19.2
/USART_RX: M1.41, U3.2
/USART_TX: M1.40, U3.3
/microcontroller/HALL_A_SENSE: C9.1, M1.75, R13.1, R14.1
/microcontroller/HALL_B_SENSE: C8.1, M1.76, R11.1, R12.1
/microcontroller/HALL_C_SENSE: C7.1, M1.22, R9.1, R10.1
/microcontroller/PC4: C11.1, M1.20, R7.1, R8.2
/microcontroller/PC5: C10.1, M1.19, R5.2, R6.1
/powerconverters/5v_FB: R3.2, R4.1, U2.4
/powerconverters/5v_OUT: D2.1, L2.1, U2.2
/powerconverters/12v_FB: R1.2, R2.1, U1.4
/powerconverters/12v_OUT: D1.1, L1.1, U1.2
/powerconverters/TransEnable: Q1.2, R16.2, U1.5
unnamed: Q1.1, R15.1, R19.1
