Rampagy/bldc/software/Control/uart.c

#include "uart.h"


uint8_t buffer[TX_BYTES+1];
int16_t desiredThrottleX10 = 0;
volatile rxBuffer_T rxBuffer;
volatile uint8_t RS485RxCompleted = 0;

/*UARTSendData
 *Populates a buffer which gets shifted out UART3 at the baud rate specified by UARTInit.
 *Note, this function is non-blocking and repeated calls will stop the current transfer and start
 *a new transfer
*/

void UARTSendData(uint16_t throttleEcho, uint16_t motorSpeed, uint16_t currentConsumption)
{
    buffer[0] = 10; // '\n'

    uint16_t divisor = 1000;
    for(uint8_t i = 1; i < (TX_BYTES/3)+1; i++)
    {
        //Copy String into Buffer
        uint8_t asciiDec = (throttleEcho / divisor);
        buffer[i] = asciiDec + 48;
        throttleEcho -= asciiDec * divisor;

        asciiDec = (motorSpeed / divisor);
        buffer[i + (TX_BYTES/3)] = asciiDec + 48;
        motorSpeed -= asciiDec * divisor;

        asciiDec = (currentConsumption / divisor);
        buffer[i + (TX_BYTES*2/3)] = asciiDec + 48;
        currentConsumption -= asciiDec * divisor;

        divisor /= 10;
    }

    // Enable the transmitter
    USART3->CR1 |= USART_Mode_Tx;
}


//USART3_IRQHandler
//Handles the USART Interrupt. On a transfer empty interrupt, populates the data register with the next character to send.
void USART3_IRQHandler (void)
{
    static uint8_t txPacketCounter = 0;
    static uint8_t rxPacketCounter = RX_BYTES+1; // prevents reading partial data

    if (USART3->SR & USART_FLAG_RXNE)
    {
        //Save the data, reading from USART3->DR clears interrupt
        uint8_t tempData = USART3->DR;

        if (tempData == 10)
        {
            // Every packet starts with a '\n'
            rxPacketCounter = 0;
        }
        else if (rxPacketCounter < RX_BYTES && tempData >= '0' && tempData <= '9')
        {
            rxBuffer.u8_data[rxPacketCounter] = tempData;
            rxPacketCounter++;
        }

        // set complete flag when '\n' followed by 4 data bytes are received
        if (rxPacketCounter == RX_BYTES)
        {
            RS485RxCompleted = 1;
            rxPacketCounter = RX_BYTES+1; // prevents reading partial data
        }
    }
    else if(USART3->SR & USART_FLAG_TC)
    {
        if (txPacketCounter >= (TX_BYTES+1))
        {
            //disable transmit mode, clear the data register and clear the flag
            USART3->CR1 &= ~USART_Mode_Tx;
            USART_SendData(USART3, 0);
            txPacketCounter = 0;
        }
        else
        {
            //Put the next data in the Data Register
            USART3->DR = buffer[txPacketCounter];
            txPacketCounter++;
        }
    }
    return;
}


// this interrupt should only get hit if we are not receiving RS485 messages
void TIM8_TRG_COM_TIM14_IRQHandler (void)
{
    if (TIM_GetITStatus(TIM14, TIM_IT_Update) != RESET)
    {
        desiredThrottleX10 = 0;
        GPIO_SetBits(GPIOD, LED_BLUE);
        TIM_ClearITPendingBit(TIM14, TIM_IT_Update);  //reset flag
    }
    return;
}


//UARTInit
//Initializes Pins 8 and 9 on GPIO D to UART3.
//Inputs: baudRate: Desired Baud Rate for Serial Communication
void UARTInit(uint32_t baudRate)
{
    GPIO_InitTypeDef GPIO_InitStructure;
    TIM_TimeBaseInitTypeDef  TIM_InitStructure1;
    USART_InitTypeDef USART_InitStructure;
    NVIC_InitTypeDef NVIC_InitStructure;

    //Enable GPIOD Clock Power
    RCC_AHB1PeriphClockCmd(RCC_AHB1Periph_GPIOD, ENABLE);
    //Enable USART3 Clock Power
    RCC_APB1PeriphClockCmd(RCC_APB1Periph_USART3, ENABLE);
    //Enable TIM14 power
    RCC_APB1PeriphClockCmd(RCC_APB1Periph_TIM14, ENABLE);

    // pin 8 and 9 for UART
    GPIO_InitStructure.GPIO_Pin = GPIO_Pin_8 | GPIO_Pin_9;
    GPIO_InitStructure.GPIO_Mode = GPIO_Mode_AF;
    GPIO_InitStructure.GPIO_OType = GPIO_OType_PP;
    GPIO_InitStructure.GPIO_PuPd = GPIO_PuPd_DOWN;
    GPIO_InitStructure.GPIO_Speed = GPIO_Speed_100MHz;
    GPIO_Init(GPIOD, &GPIO_InitStructure);

    /* Connect USART Pins to GPIO */
    GPIO_PinAFConfig(GPIOD, GPIO_PinSource8, GPIO_AF_USART3);
    GPIO_PinAFConfig(GPIOD, GPIO_PinSource9, GPIO_AF_USART3);

    USART_InitStructure.USART_BaudRate = baudRate;
    USART_InitStructure.USART_WordLength = USART_WordLength_8b;
    USART_InitStructure.USART_StopBits = USART_StopBits_1;
    USART_InitStructure.USART_Parity = USART_Parity_No;
    USART_InitStructure.USART_Mode = USART_Mode_Rx;
    USART_InitStructure.USART_HardwareFlowControl = USART_HardwareFlowControl_None;
    USART_Init(USART3,&USART_InitStructure);

    //Enable UART interrupt
    NVIC_InitStructure.NVIC_IRQChannel = USART3_IRQn;
    NVIC_InitStructure.NVIC_IRQChannelPreemptionPriority = 0x00;
    NVIC_InitStructure.NVIC_IRQChannelSubPriority = 0x00;
    NVIC_InitStructure.NVIC_IRQChannelCmd = ENABLE;
    NVIC_Init(&NVIC_InitStructure);

    /* timer 14 initialization for UART Rx timeout */
    TIM_InitStructure1.TIM_Prescaler = 42; // TIM14 base clock is 42MHz
    TIM_InitStructure1.TIM_CounterMode = TIM_CounterMode_Up;
    TIM_InitStructure1.TIM_Period = 50000; // Each tick is 1 us
    TIM_InitStructure1.TIM_ClockDivision = TIM_CKD_DIV1;

    TIM_TimeBaseInit(TIM14, &TIM_InitStructure1);
    TIM_Cmd(TIM14, ENABLE);

    /* Timer 14 Interrupt Config */
    NVIC_InitStructure.NVIC_IRQChannel = TIM8_TRG_COM_TIM14_IRQn;
    NVIC_InitStructure.NVIC_IRQChannelPreemptionPriority = 0x01;
    NVIC_InitStructure.NVIC_IRQChannelSubPriority = 0x00;
    NVIC_InitStructure.NVIC_IRQChannelCmd = ENABLE;
    NVIC_Init(&NVIC_InitStructure);

    // Enable interrupt
    TIM_ITConfig(TIM14, TIM_IT_Update, ENABLE);
    TIM14->CNT = 0x00;

    USART3->SR = 0x00;
    USART3->DR = 0x00;
    USART_ITConfig(USART3, USART_IT_TC, ENABLE);
    USART_ITConfig(USART3, USART_IT_RXNE, ENABLE);

    USART_Cmd(USART3, ENABLE); //Enable UART3


    return;
}
