Rampagy/bldc/(commit log)

2018-03-16 setup initial project
    [BLDC_V1_P1.sch, BLDC_V1_P2.sch, BLDC_V1_P3.sch, bldc_v1.kicad_pcb, bldc_v1.sch]
2018-03-18 Added mosfet circuit
    [BLDC_V1_P2.sch, BLDC_V1_P3.sch, GateDriver.sch, MOSFETS.sch, bldc_v1.sch]
2018-03-19 Updaated Driver section
    [GateDriver.sch, MOSFETS.sch, bldc_v1.sch]
2018-03-20 Update gate driver protection
    [GateDriver.sch, MOSFETS.sch, bldc_v1.sch]
2018-03-23 Added power converters
    [GateDriver.sch, MOSFETS.sch, PowerConverter.sch, bldc_v1.sch]
2018-03-25 added microcontroller page
    [GateDriver.sch, MOSFETS.sch, Microcontroller.sch, PowerConverter.sch, bldc_v1.sch]
2018-03-25 cleaned up schematic
    [GateDriver.sch, MOSFETS.sch, Microcontroller.sch, PowerConverter.sch, bldc_v1.sch]
2018-03-25 associated footprints
    [GateDriver.sch, MOSFETS.sch, bldc_v1.sch]
2018-03-25 annotated schematic
    [GateDriver.sch, MOSFETS.sch, Microcontroller.sch, PowerConverter.sch, bldc_v1.sch]
2018-03-29 created new footprints, modified schematic
    [MOSFETS.sch, Microcontroller.sch, PowerConverter.sch, bldc_v1.sch]
2018-03-29 dispersed condensed intitial pcb layout
    [bldc_v1.kicad_pcb]
2018-03-30 layed parts out on board
    [GateDriver.sch, MOSFETS.sch, Microcontroller.sch, PowerConverter.sch, bldc_v1.kicad_pcb, bldc_v1.sch]
2018-03-30 added updated schematic
2018-04-04 finished board layout
    [bldc_v1.kicad_pcb]
2019-01-25 updated board layout
    [GateDriver.sch, MOSFETS.sch, Microcontroller.sch, PowerConverter.sch, bldc_v1.kicad_pcb, bldc_v1.sch]
2019-01-25 updated part numbers
    [GateDriver.sch, MOSFETS.sch, Microcontroller.sch, PowerConverter.sch, bldc_v1.sch]
2019-01-26 Converted to kicad 5
    [GateDriver.sch, MOSFETS.sch, Microcontroller.sch, PowerConverter.sch, bldc_v1.sch]
2019-01-26 updated net, sch. removed old board layout
    [GateDriver.sch, MOSFETS.sch, Microcontroller.sch, PowerConverter.sch, bldc_v1.kicad_pcb, bldc_v1.sch]
2019-01-26 Initial Board layout
    [bldc_v1.kicad_pcb]
2019-01-27 routed phase A power electronics
    [bldc_v1.kicad_pcb]
2019-01-27 routed phase B power electronics
    [bldc_v1.kicad_pcb]
2019-01-27 Completed routing
    [bldc_v1.kicad_pcb]
2019-01-28 Added additional planes for extra current
    [bldc_v1.kicad_pcb]
2019-01-29 updated routing and all plots
    [GateDriver.sch, MOSFETS.sch, bldc_v1.kicad_pcb, bldc_v1.sch]
2019-01-31 Updated schematic for additional capacitors
    [GateDriver.sch, MOSFETS.sch, PowerConverter.sch, bldc_v1.kicad_pcb, bldc_v1.sch]
2019-01-31 Added additional capacitors for 48v bus
    [MOSFETS.sch, PowerConverter.sch, bldc_v1.kicad_pcb, bldc_v1.sch]
2019-02-02 completely restarted
    [GateDriver.sch, MOSFETS.sch, Microcontroller.sch, PowerConverter.sch, bldc_v1.kicad_pcb, bldc_v1.sch, gatedrivers.sch, mosfets.sch]
2019-02-02 rearranged files
    [bldc_v1.kicad_pcb, bldc_v1.sch, gatedrivers.sch, mosfets.sch]
2019-02-02 added mounting holes and updates schematic areas
    [bldc_v1.sch, gatedrivers.sch]
2019-02-02 Added control schematic
    [control_v1.kicad_pcb, control_v1.sch, microcontroller.sch, powerconverters.sch]
2019-02-03 Added capacitor to 5v bus on power board
    [bldc_v1.sch, mosfets.sch]
2019-02-03 committing current state of report
2019-02-04 Added gate driver section
2019-02-05 updated schematic with voltage divider
    [microcontroller.sch]
2019-02-08 updated schematics, added shoot through protection
    [bldc_v1.sch, control_v1.sch, microcontroller.sch, mosfets.sch, powerconverters.sch, shootthroughprotection.sch]
2019-02-09 removed shootthourgh protection
    [control_v1.sch, microcontroller.sch, powerconverters.sch, shootthroughprotection.sch]
2019-02-09 Added footprints for each component
    [control_v1.sch, microcontroller.sch, powerconverters.sch]
2019-02-10 Added auxilary components
    [control_v1.sch, microcontroller.sch]
2019-02-10 started board layout
    [control_v1.kicad_pcb, control_v1.sch, microcontroller.sch]
2019-02-13 Added filter components and baord layout
    [control_v1.kicad_pcb, control_v1.sch, microcontroller.sch]
2019-02-13 Added pdf for board layout
2019-02-14 Laid all traces, updated documentation
    [control_v1.kicad_pcb, control_v1.sch, microcontroller.sch]
2019-02-19 Added drill files
    [control_v1-B.Cu.gbl, control_v1-B.Mask.gbs, control_v1-B.SilkS.gbo, control_v1-Edge.Cuts.gm1, control_v1-F.Cu.gtl, control_v1-F.Mask.gts, control_v1-F.SilkS.gto, control_v1.drl]
2019-02-22 Wrote section on 5v converter
2019-03-09 Updated to rev 2
    [control_v1.kicad_pcb, control_v1.sch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]
2019-03-16 Added Transmission Enable
    [control_v1.kicad_pcb, control_v1.sch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]
2019-03-21 Added RS485 differential pair
    [control_v1.kicad_pcb, control_v1.sch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]
2019-03-21 Adding arduino board
    [Operator.kicad_pcb, Operator.sch]
2019-03-21 Updated schematic for termination resistors
    [control_v1.sch]
2019-03-22 Added termination resistors
    [control_v1.kicad_pcb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]
2019-03-22 Adding 0.1" pin headers
    [Operator.sch]
2019-03-22 Added gerber files
    [Operator.kicad_pcb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]
2019-03-23 Updated Gerber files
    [Operator-B.Cu.gbl, Operator-B.Mask.gbs, Operator-B.SilkS.gbo, Operator-Edge.Cuts.gm1, Operator-F.Cu.gtl, Operator-F.Mask.gts, Operator-F.SilkS.gto, Operator.drl]
2019-03-27 Added decoupling cap for rs485 chip
    [Operator.kicad_pcb, Operator.sch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]
2019-03-27 Added decoupling cap for RS485
    [control_v1.kicad_pcb, control_v1.sch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]
2019-03-27 Updated decoupling capacitor value
    [Operator.sch]
2019-03-27 Added mask
    [Operator.kicad_pcb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]
2019-03-27 Created silk screen
    [Operator.kicad_pcb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]
2019-04-16 Addedcurrent limiting resistor, increased 2.2uF cap footprint
    [control_v1-B.Cu.gbl, control_v1-B.Mask.gbs, control_v1-B.SilkS.gbo, control_v1-Edge.Cuts.gm1, control_v1-F.Cu.gtl, control_v1-F.Mask.gts, control_v1-F.SilkS.gto, control_v1.drl]
2019-04-17 Updated footprint size, put arduino on opposite side of board.
    [Operator-B.Cu.gbl, Operator-B.Mask.gbs, Operator-B.SilkS.gbo, Operator-Edge.Cuts.gm1, Operator-F.Cu.gtl, Operator-F.Mask.gts, Operator-F.SilkS.gto, Operator.drl]
2019-04-24 Removed and added files until all errors were gone
    [main.c]
2019-04-27 Added RS485 bias resistors
    [control_v1-B.Cu.gbl, control_v1-B.Mask.gbs, control_v1-B.SilkS.gbo, control_v1-Edge.Cuts.gm1, control_v1-F.Cu.gtl, control_v1-F.Mask.gts, control_v1-F.SilkS.gto, control_v1.drl]
2019-04-27 Updated silk screen
    [Operator-B.Cu.gbl, Operator-B.Mask.gbs, Operator-B.SilkS.gbo, Operator-Edge.Cuts.gm1, Operator-F.Cu.gtl, Operator-F.Mask.gts, Operator-F.SilkS.gto, Operator.drl]
2019-04-27 Updated Documentation
    [control_v1-B.Cu.gbl, control_v1-B.Mask.gbs, control_v1-B.SilkS.gbo, control_v1-Edge.Cuts.gm1, control_v1-F.Cu.gtl, control_v1-F.Mask.gts, control_v1-F.SilkS.gto, control_v1.drl]
2019-04-29 Hall effect working with USART output
2019-04-30 Added TIM9 interrupt
2019-05-01 Removed voltage biasing resistors from control board
    [control_v1-B.Cu.gbl, control_v1-B.Mask.gbs, control_v1-B.SilkS.gbo, control_v1-Edge.Cuts.gm1, control_v1-F.Cu.gtl, control_v1-F.Mask.gts, control_v1-F.SilkS.gto, control_v1.drl]
2019-05-05 Added 10ms task to arduino code
2019-05-08 Update voltage divider on 12v enable transistor
    [control_v1-B.Cu.gbl, control_v1-B.Mask.gbs, control_v1-B.SilkS.gbo, control_v1-Edge.Cuts.gm1, control_v1-F.Cu.gtl, control_v1-F.Mask.gts, control_v1-F.SilkS.gto, control_v1.drl]
2019-05-08 Made arduino holes bigger
    [Operator-B.Cu.gbl, Operator-B.Mask.gbs, Operator-B.SilkS.gbo, Operator-Edge.Cuts.gm1, Operator-F.Cu.gtl, Operator-F.Mask.gts, Operator-F.SilkS.gto, Operator.drl]
2019-05-11 Updated debug LEDs
2019-05-20 Adding interrupt priority updates
2019-05-21 Added slew to 25% throttle
2019-06-06 Adding 12v toggle
2019-06-06 Scheduled debug to be sent after Rx to avoid overruns
    [debug.c, main.c, main.h, uart.c]
2019-06-14 Added complementary PWM
2019-06-18 Updated orange LED functionality
2019-06-18 Updated slew and orange LED functionality
2019-06-18 Updated Timers
2019-06-19 Trying design of experiments to figure out complementary PWM
2019-06-20 Updated PWM output
2019-07-06 Added Motor control theory
2019-07-13 updated to kciad projects to 5.1.2
    [control_v1.sch, microcontroller.sch, powerconverters.sch]
2019-09-07 Updating schematic
    [bldc_v1.sch]
2019-09-07 Added Footprints
    [bldc_v1.sch, gatedrivers.sch]
2019-09-11 Updating footprints
    [bldc_v1.sch, mosfets.sch]
2019-09-14 Updating schematic with new footprints
    [bldc_v1.sch]
2019-09-14 Adding new footprints
2019-09-14 Added more capacitance
    [bldc_v1.sch, gatedrivers.sch, mosfets.sch]
2019-10-27 Updated RS485 RX driver
2019-10-28 Fixed 2 byte RS485 receives
    [debug.c, debug.h, main.c, main.h, motor_control.c, motor_control.h]
2019-10-28 Set baudrate, fixed PWM calculations
    [main.c, main.h, motor_control.c, motor_control.h, uart.c]
2019-10-28 Added moving average filter for speed
2019-10-30 Updated RS485 driver to be more robust
2019-11-02 Updated Speed Sensor and UART driver
2019-11-05 Fixing UART Rx bug
    [operator.ino]
2019-11-11 Updating motor control
2022-12-08 Adding parts list
    [Parts List 2.0.xlsx]
